clockdiv/MechanicalTheatre/README.md

# MechanicalTheatre
Control multiple Stepper Motors with Blender Timeline
