clockdiv/MechanicalTheatre/HARDWARE/Bedienung Platine.pdf

# Power Consumption

5V, 500mA
24V, ??mA

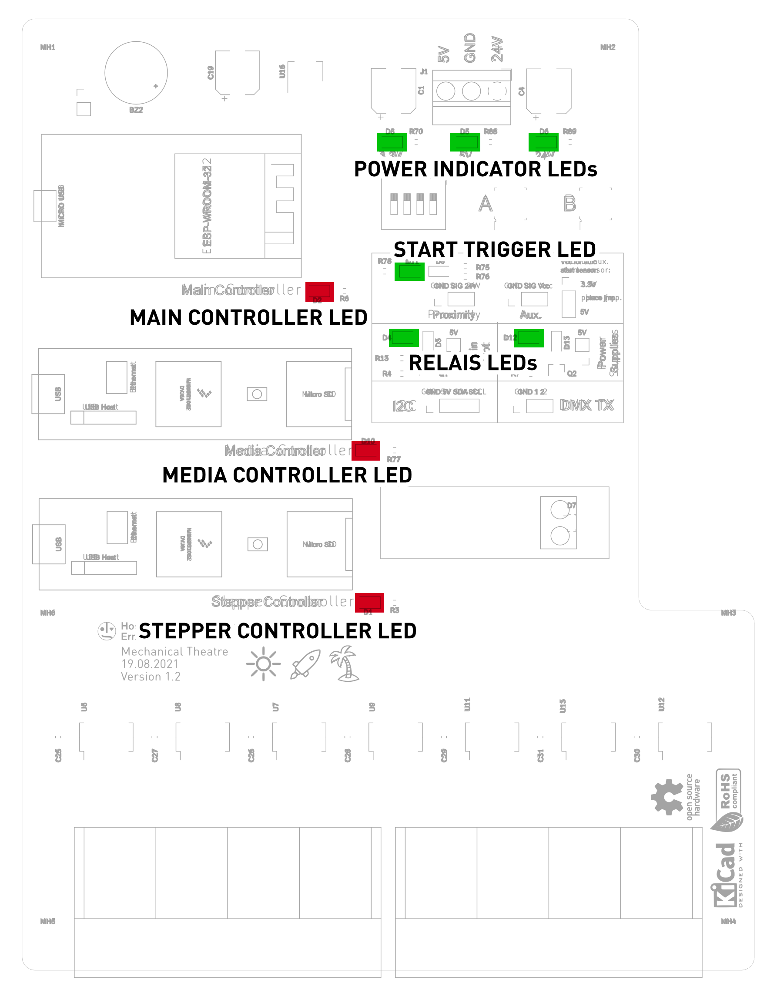
[picture p1: figure]

# LEDs

## Green LEDs Indicators

## Red LED “Main Controller” Status and Error Messages

## Red LED “Media Controller” Status and Error Messages

## Red LED “Stepper Controller” Status and Error Messages

Power Indicator LEDs | Check if Board is powered with all necessary voltages
Start Trigger LED | Lights up when the Coin-Sensor (or an auxillary sensor) is triggered
Relais LED | Corresponding LED lights up when either the Power Supply Relais or the solenoid at the coin slot is triggered
of | everything ok, waiting for start (__IDLE)
blinks fast (100ms) | ESP32 waits for teensy to reset (__WAIT_FOR_TEENSY)
blinks slow (1s) | Show is Playing (__PLAY)
blinks very slow (2s) | Stepper Controller is in test-mode (__HARDWARE_TEST)
of | everything ok, waiting for start (__IDLE)
blinks slow (1s) | Show is Playing (__PLAY)

blink codes with two seconds pause between blink-code:

1 blink | Initialization of SD-Card failed
2 blinks | Failed to read files from SD-Card
3 blinks | Failed to write files to SD-Card
of | everything ok (__IDLE)
blinks fast (100ms) | Resetting Motors (__RESET, __WAIT_FOR_MOTOR_INIT)
blinks slow (1s) | Show is Playing (__PLAY)
blinks very slow (2s) | Stepper Controller is in test-mode (__HARDWARE_TEST)

blink codes with two seconds pause between blink-code:

1 blink | Initialization of SD-Card failed
2 blinks | Failed to read files from SD-Card

# Dip Switch

# Buttons

# Buzzer (Status and Error Messages)

# RJ45 Terminals

DMX Transmitter - on Port 16 at the RJ45 terminal

- via the three-pin jumper labeled “DMX TX”
- via the green terminal on the blue MAX485 board

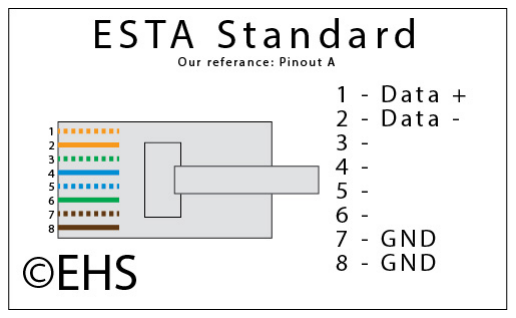
[picture p2: figure]

Port 16 at the RJ45-Terminal follows the ESTA Standard connection:
1 | Data + (A)
2 | Data - (B)
3-8 | GND
1 | auto-repeat on / of
2 | keep 24V Power Supply always on

3

4 | buzzer on / of
A | start show
B | stop show
5 | 6 | 7 | 8 | 13 | 14 | 15 | 16
1 | 2 | 3 | 4 | 9 | 10 | 11 | 12

# Test Mode

Don’t use the TestMode when all motors are attached at the installation. Motors will run without stopping at the end-switches!

1) Hold down button A while powering on OR hold down button A and press RST on Main Controller.
Only the MainController is now in TestMode:
- Three red LEDS (MainController, Relais Coinslot, Relais Power) toggle every two seconds and a short “be-beep” sounds from the speaker.
- When a serial monitor connection is established with the ESP32, the states of the buttons are presented there
2) When in TestMode, press:
- Button A to start Media Codntroller (plays the show)
- Button B to start Stepper Controller in TestMode (all motors drive slowly and stop when the endswitch is pressed)
