clockdiv/MechanicalTheatre/HARDWARE/Beschriftung RJ45-Buchsen.pdf

5 Pferde 1 | 6 Pferde 2 | 7 Reiter 1 | 8 Reiter 2
1 Ufo X-Achse | 2 Ufo Y-Achse | 3 Schwäne schwim. | 4 Schwäne tauchen
13 Stop Schild | 14 N.C. | 15 N.C. | 16 DMX Lichter
9 Luft-pumpe | 10 Halb-kugel | 11 Vorhang | 12 Magd
