clockdiv/MechanicalTheatre/2025-11-15-notes-part-04.pdf

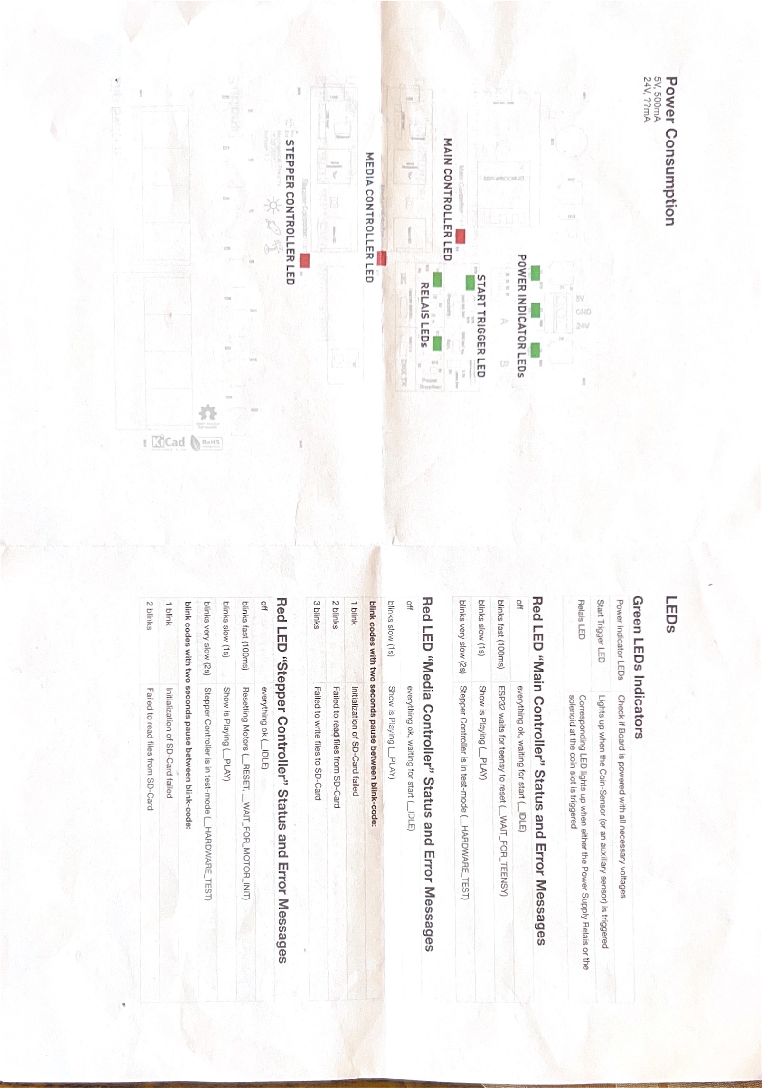
[picture p3: page 1]
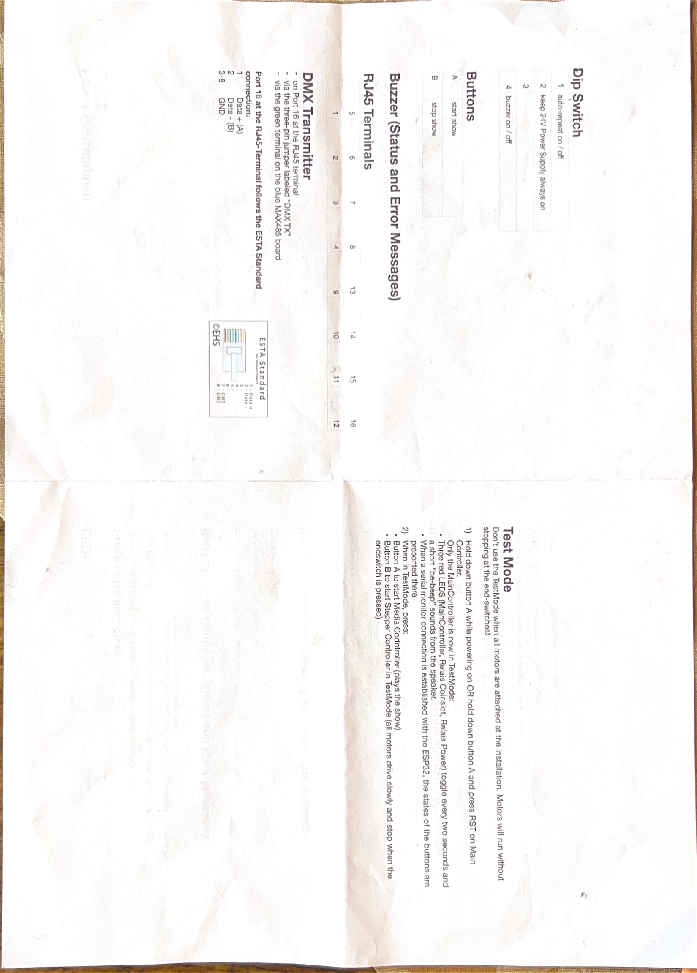
[picture p4: page 2]
