clockdiv/MechanicalTheatre/HARDWARE/LEDWall schematic.jpg

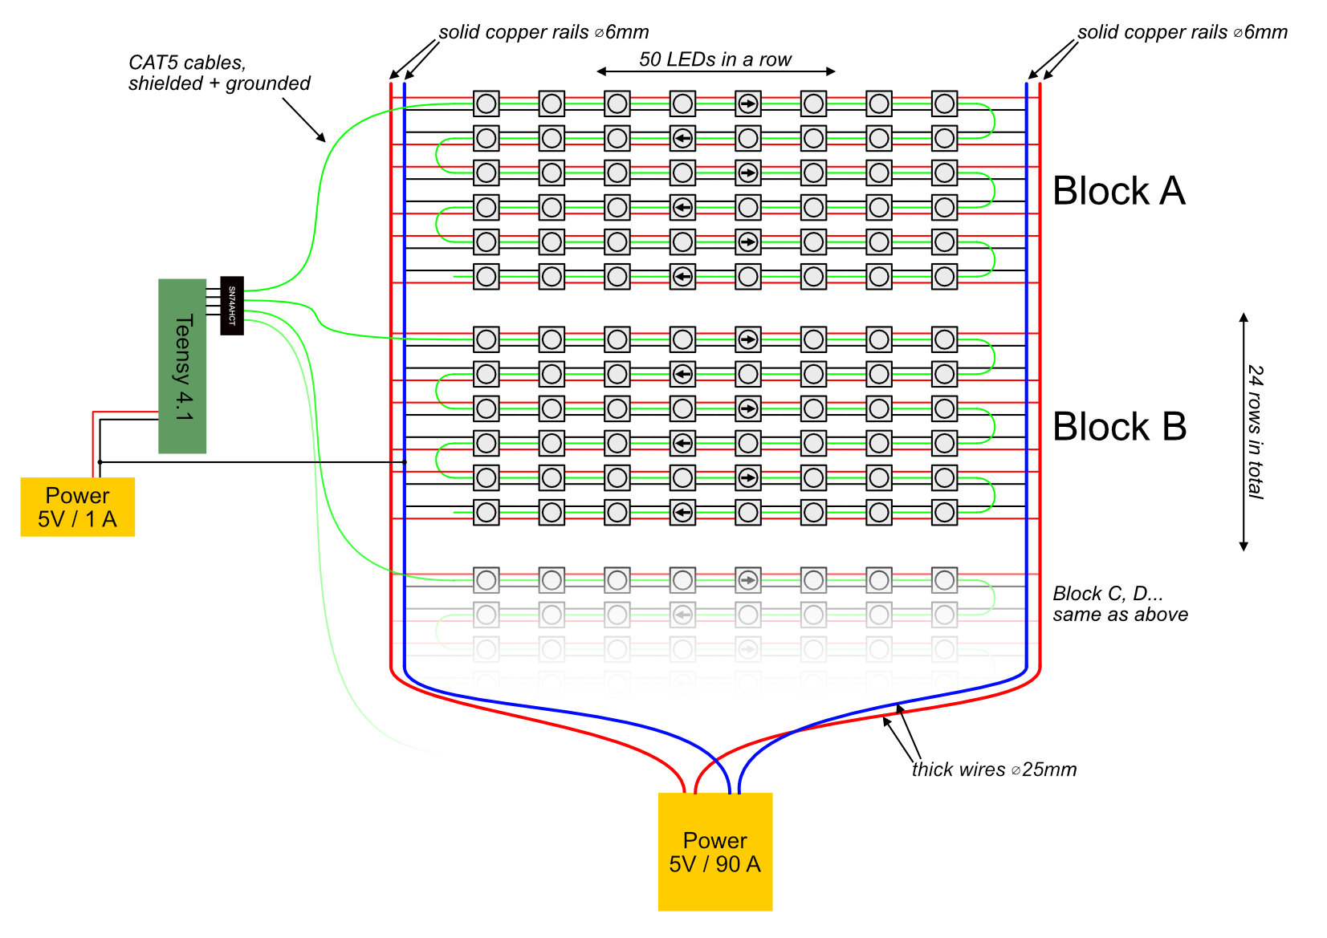
HARDWARE/LEDWall schematic.jpg
