clockdiv/MechanicalTheatre/HARDWARE/PCB/MechanicalTheatre/Silkscreen.png

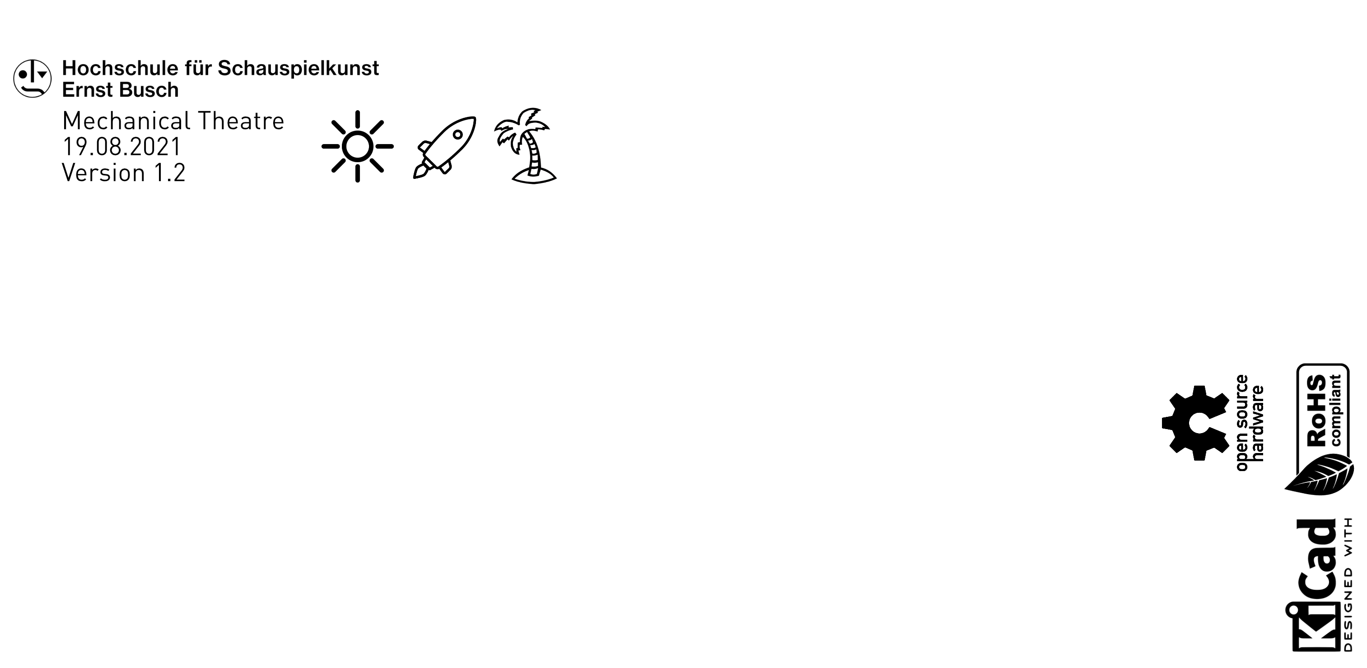
HARDWARE/PCB/MechanicalTheatre/Silkscreen.png
