clockdiv/MechanicalTheatre/HARDWARE/RJ45-Terminalblock-Adapter-KiCad-screenshot.png

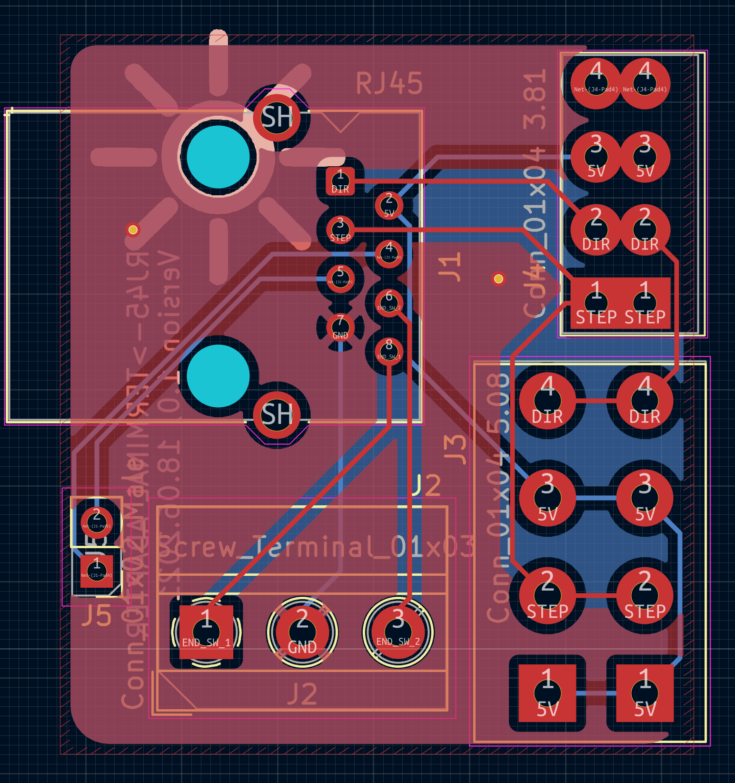
HARDWARE/RJ45-Terminalblock-Adapter-KiCad-screenshot.png
