clockdiv/MechanicalTheatre/HARDWARE/bom.xls

siehe Digikey Warenkorb | SMD LED grün | 1206
https://www.digikey.de/product-detail/de/würth-elektronik/150060SS75000/732-4979-1-ND/4489902 | SMD LED rot | 1206
https://www.digikey.de/product-detail/de/switchcraft-inc/PQG3FST112/SC1548-ND/1289547 | XLR-Connector Buchse / Flanschdose Senkrecht
https://www.digikey.de/product-detail/de/diodes-incorporated/AP2111H-3-3TRG1/AP2111H-3-3TRG1DICT-ND/4505138 | 3.3V spannungsregler
https://www.digikey.de/product-detail/de/texas-instruments/LM1117IMP-3-3-NOPB/LM1117IMP-3-3-NOPBCT-ND/483058 | 3.3V spannungsregler
https://www.digikey.de/product-detail/en/semtech-corporation/SM712.TCT/SM712CT-ND/1000976 | TVS Diode Transient Voltage Suppressor
https://www.digikey.de/product-detail/de/micro-commercial-co/1N4148W-TP/1N4148WTPMSCT-ND/717311 | Diode | SOD-123
https://www.digikey.de/product-detail/de/united-chemi-con/EMHL350ARA221MHA0G/565-EMHL350ARA221MHA0GCT-ND/10487113 | Elko 220uF / 35V
https://www.digikey.de/product-detail/de/panasonic-electronic-components/EEE-1EA101P/PCE3896CT-ND/766272 | Elko 100uF / 25V
