clockdiv/MechanicalTheatre/(list of files, cad)

Other CAD files:
DEV BLENDER/DumpTimelineToFile.blend
DEV BLENDER/DumpTimelineToFile2.blend
DEV BLENDER/DumpTimelineToFile3.blend
DEV BLENDER/Ingo V2.blend
DEV BLENDER/Ingo V3.blend
DEV BLENDER/Ingo V4.blend
DEV BLENDER/Ingo V5.blend
DEV BLENDER/Timeline2DMX.blend
