clockdiv/MechanicalTheatre/HARDWARE/Schaltplan.pdf

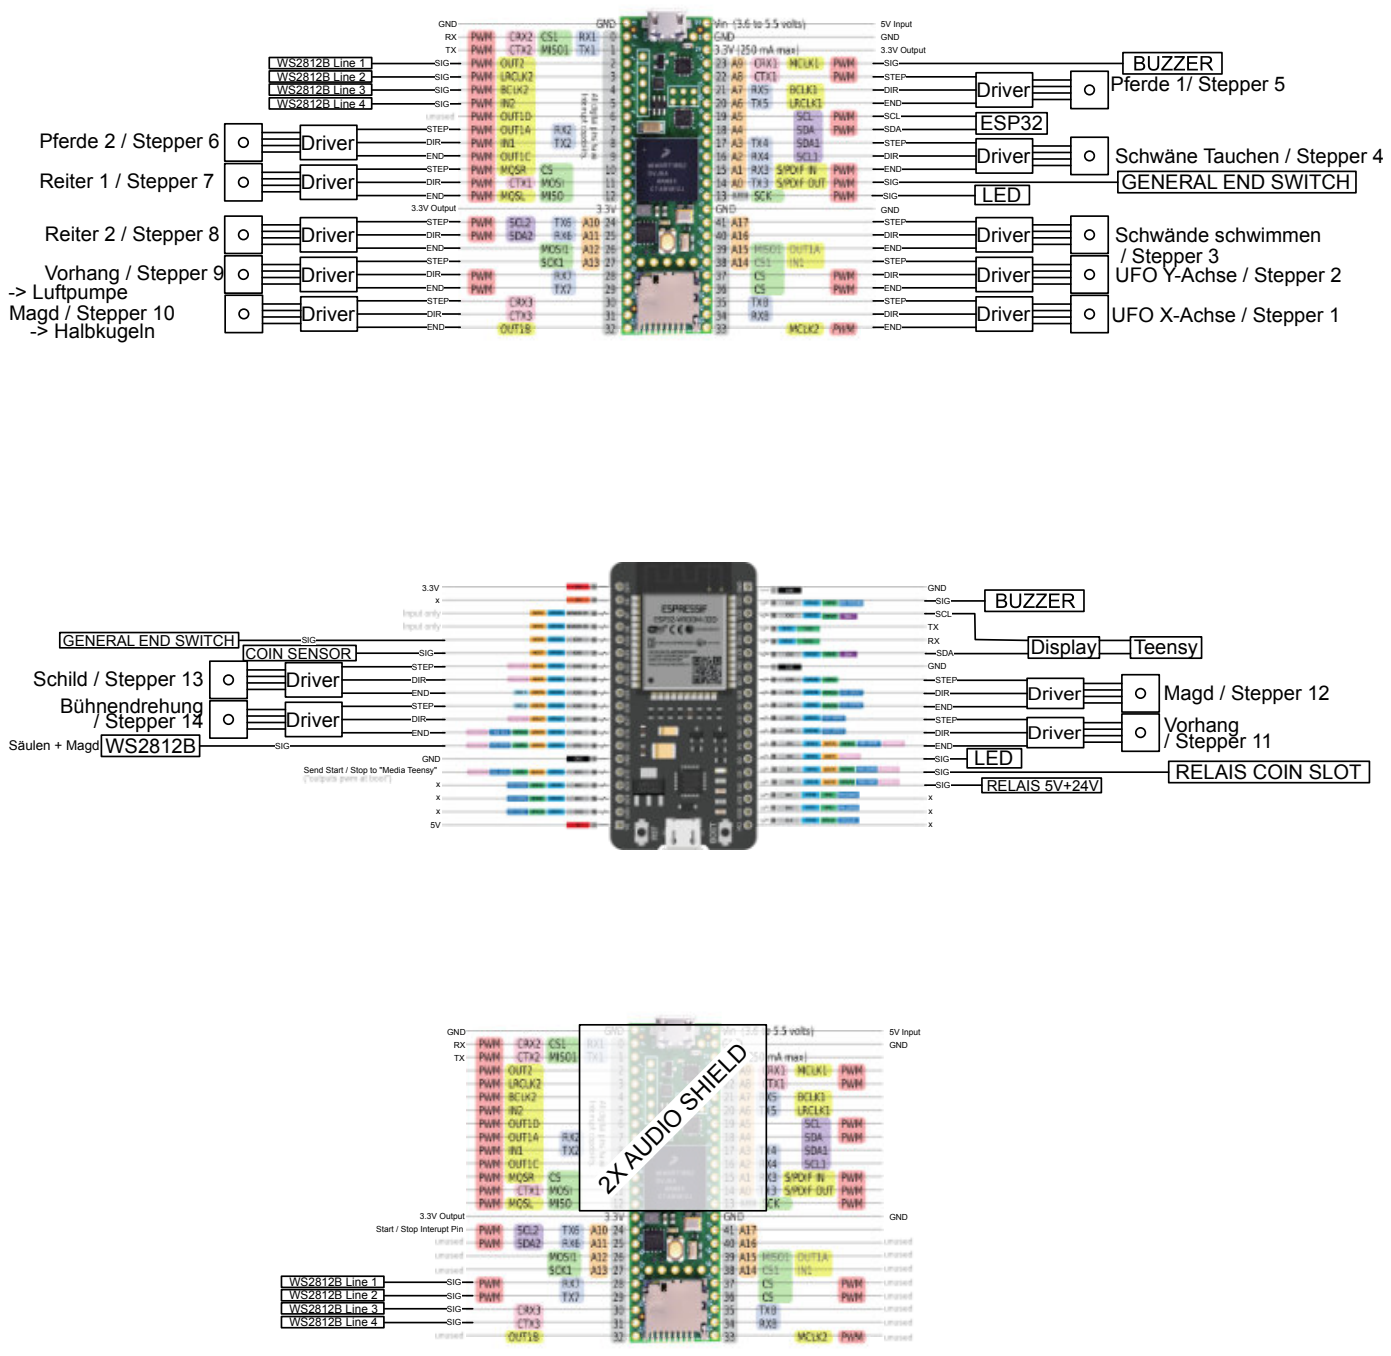
[picture p13: page 1]
ESP32 SCL; SDA; SIG; LED; GENERAL END SWITCH; Säulen + Magd; COIN SENSOR; WS2812B Line 1; WS2812B Line 2; WS2812B Line 3; WS2812B Line 4; RELAIS COIN SLOT SIG; RELAIS 5V+24V; Display; Teensy; SCL; Driver; STEP; DIR; END; Pferde 1/ Stepper 5; UFO X-Achse / Stepper 1; Magd / Stepper 12; Vorhang; / Stepper 11; Pferde 2 / Stepper 6; Schild / Stepper 13; Reiter 1 / Stepper 7; Driver Bühnendrehung / Stepper 14; Reiter 2 / Stepper 8; Vorhang / Stepper 9; -> Luftpumpe; Magd / Stepper 10; -> Halbkugeln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

Schwäne Tauchen / Stepper 4

Schwände schwimmen
/ Stepper 3
UFO Y-Achse / Stepper 2

Send Start / Stop to "Media Teensy"

Start / Stop Interupt Pin
