clockdiv/MechanicalTheatre/HARDWARE/PCB/MechanicalTheatre/MechanicalTheatre.pdf

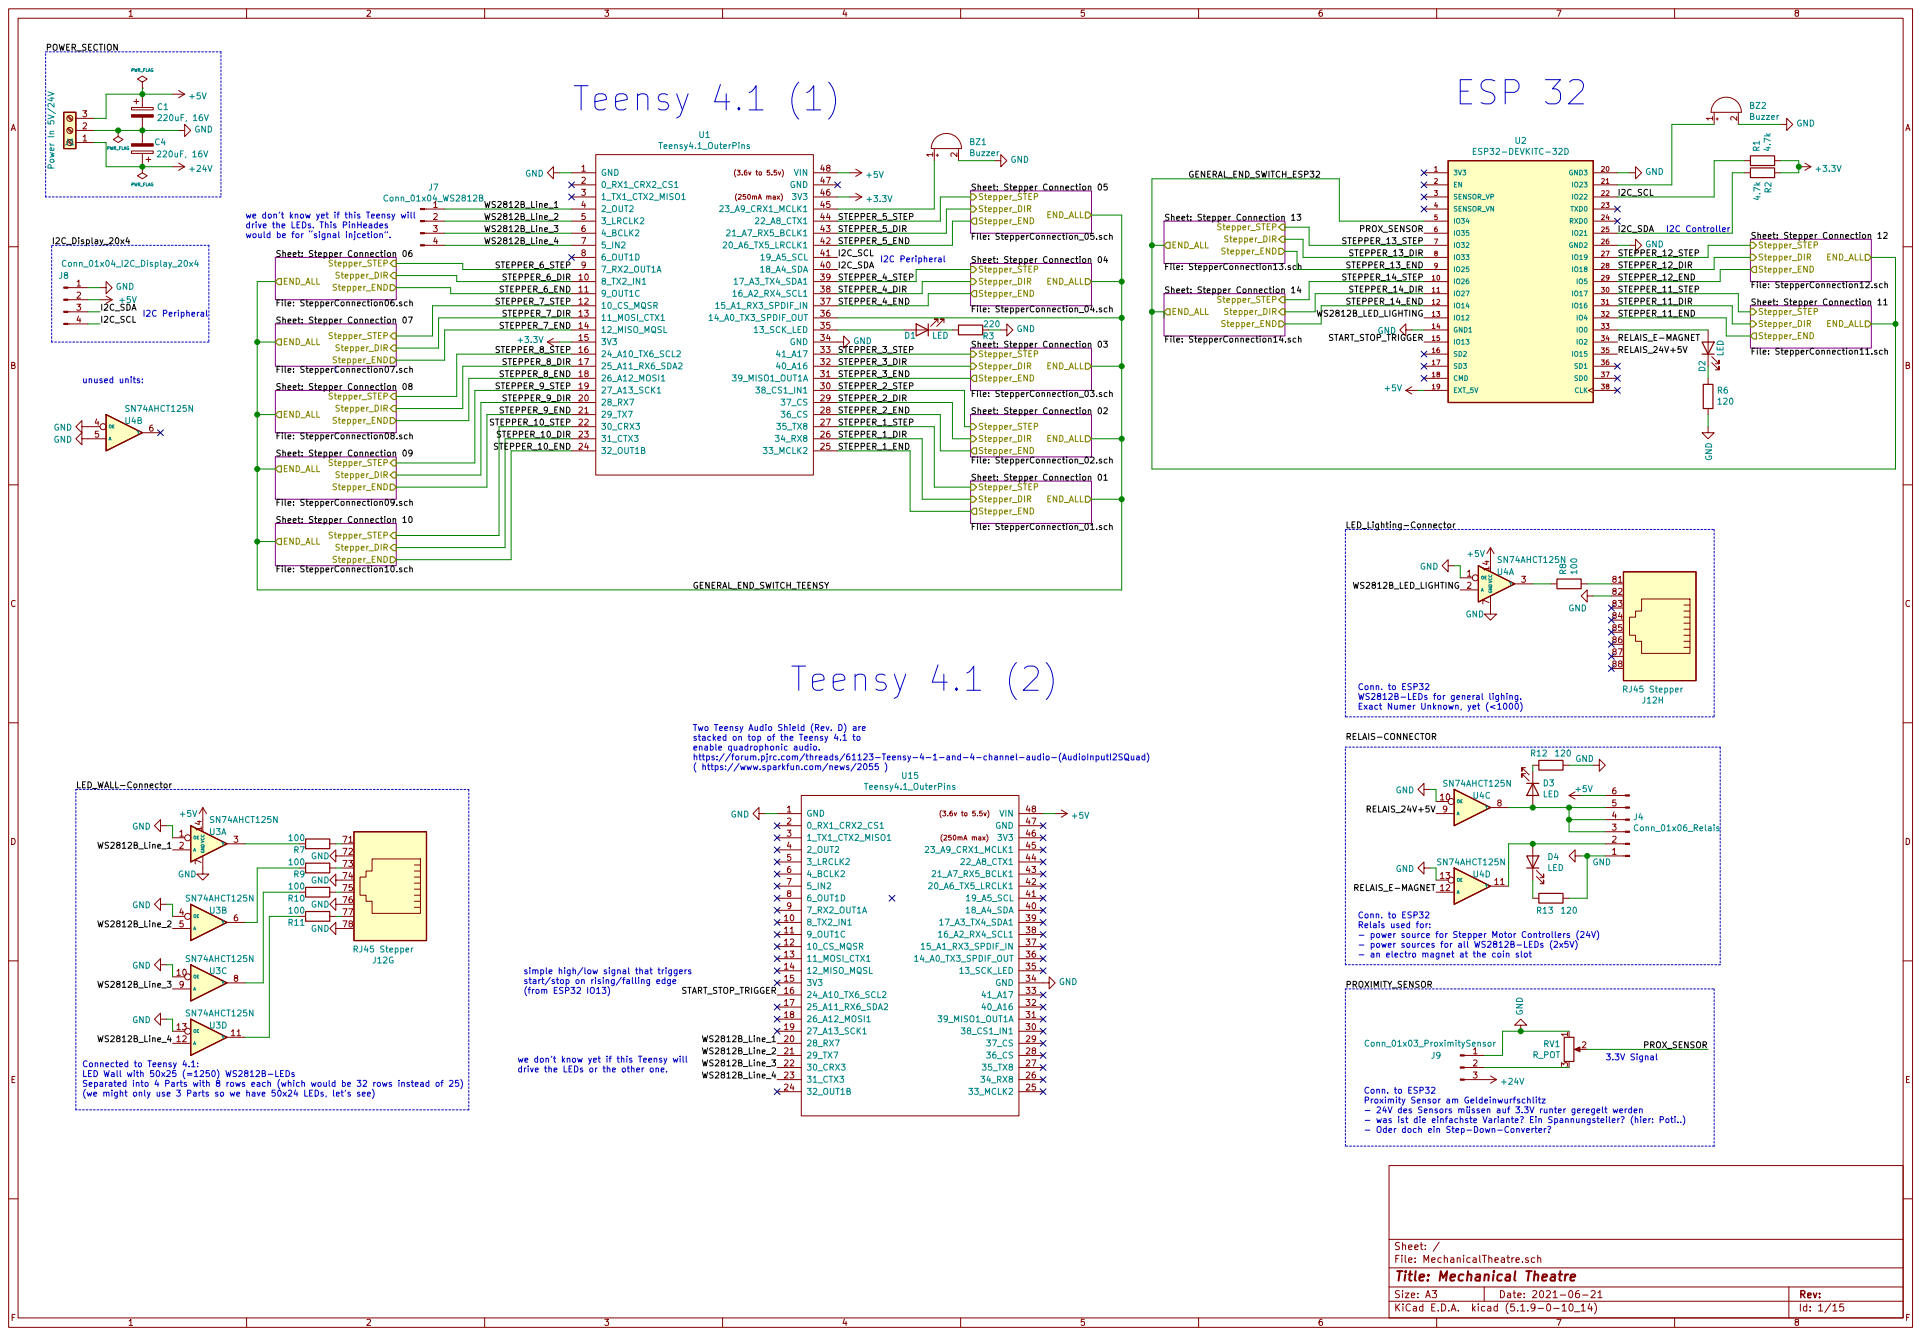
[picture p14: page 1]

we dont know yet if this Teensy will drive the LEDs. This PinHeades would be for signal injcetion.

3.3V Signal Conn. to ESP32 WS2812B-LEDs for general lighing.

Exact Numer Unknown, yet (<1000)

Two Teensy Audio Shield (Rev. D) are
stacked on top of the Teensy 4.1 to
enable quadrophonic audio.
https://forum.pjrc.com/threads/61123-Teensy-4-1-and-4-channel-audio-(AudioInputI2SQuad)

- power sources for all WS2812B-LEDs (2x5V)
- an electro magnet at the coin slot

simple high/low signal that triggers
start/stop on rising/falling edge
(from ESP32 IO13)

we dont know yet if this Teensy will drive the LEDs or the other one.

Connected to Teensy 4.1:
LED Wall with 50x25 (=1250) WS2812B-LEDs
Separated into 4 Parts with 8 rows each (which would be 32 rows instead of 25)
(we might only use 3 Parts so we have 50x24 LEDs, lets see)

Conn. to ESP32 Proximity Sensor am Geldeinwurfschlitz

- 24V des Sensors müssen auf 3.3V runter geregelt werden
- was ist die einfachste Variante? Ein Spannungsteiler? (hier: Poti..)
- Oder doch ein Step-Down-Converter?

File: MechanicalTheatre.sch Sheet: /
Id: 1/15 Title: Mechanical Theatre

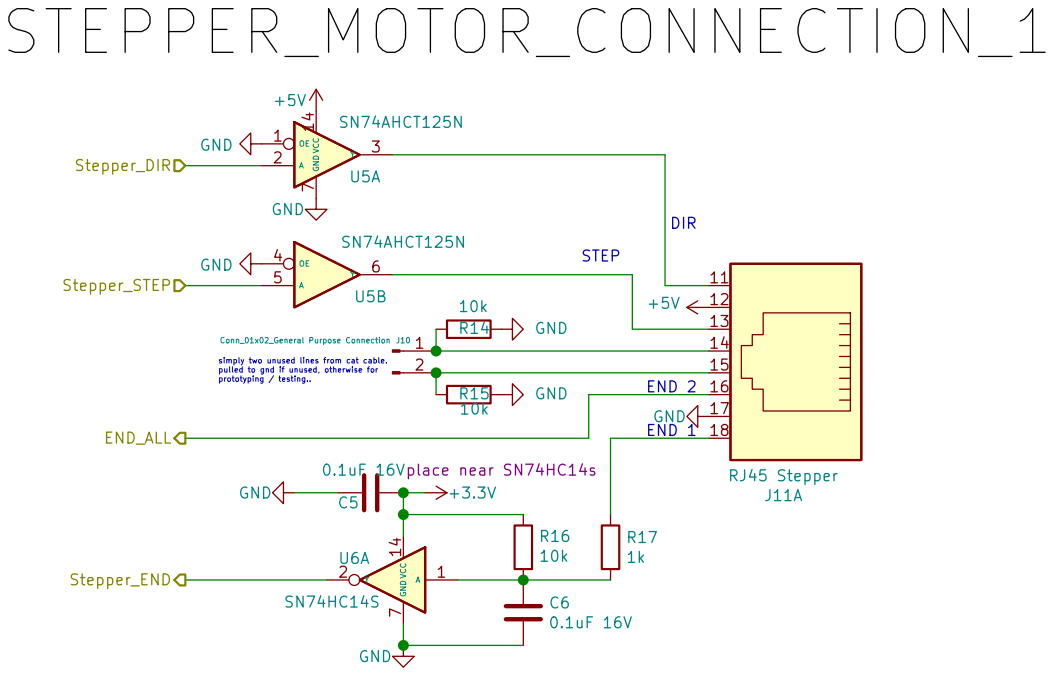
[picture p15: page 2]

Sheet: /Stepper Connection 01/
File: StepperConnection_01.sch
Id: 2/15 Title: Stepper Connection

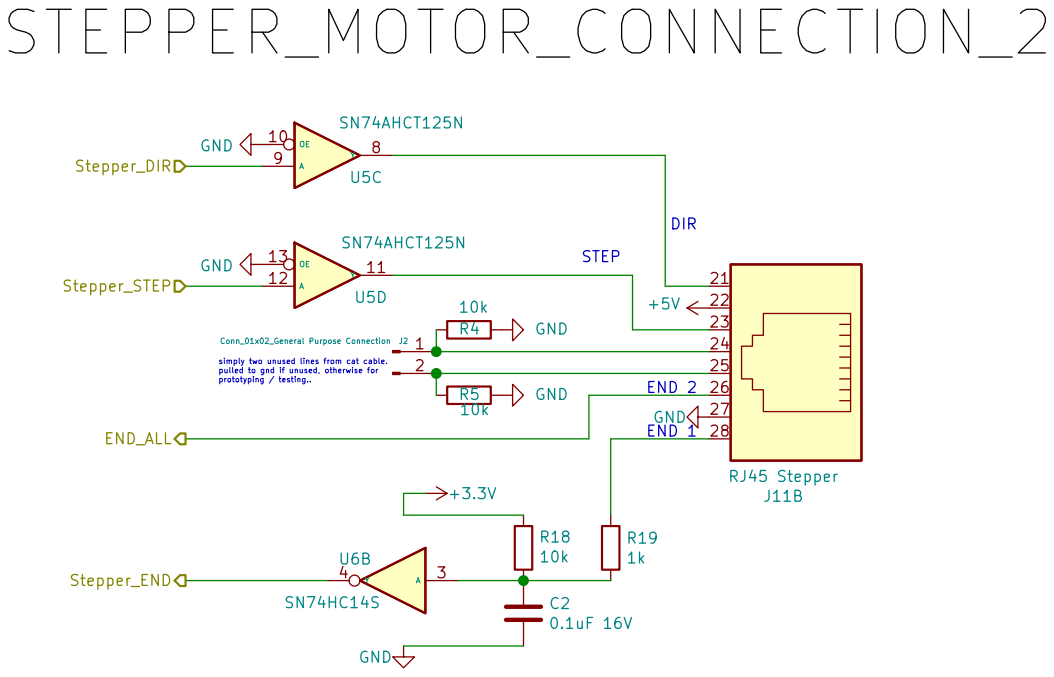
[picture p16: page 3]

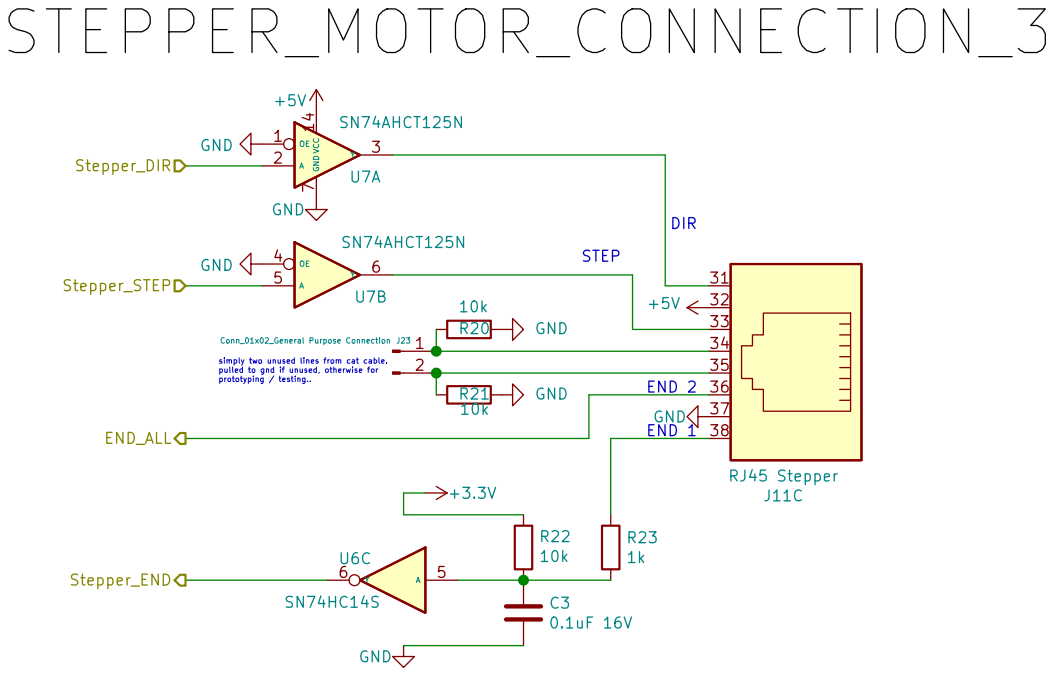
[picture p17: page 4]

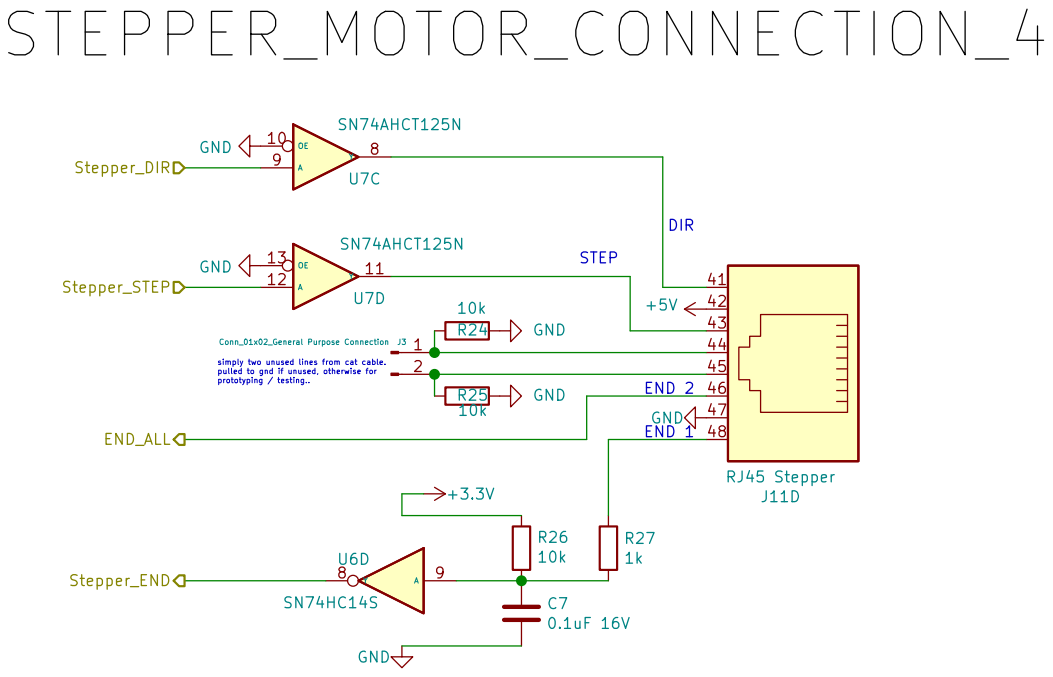
[picture p18: page 5]

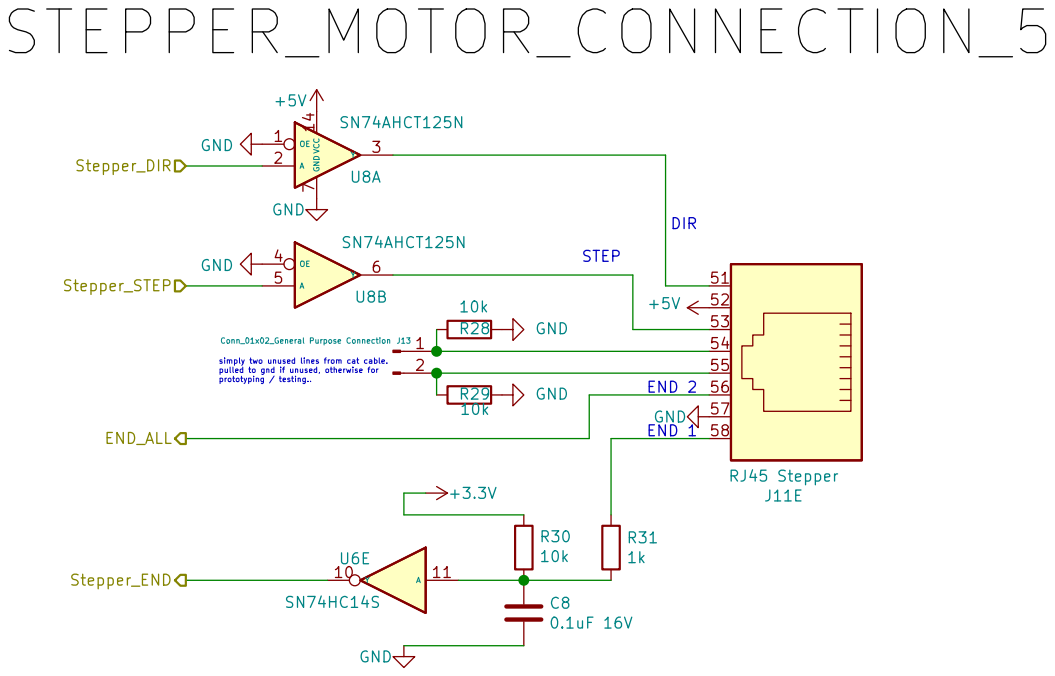
[picture p19: page 6]

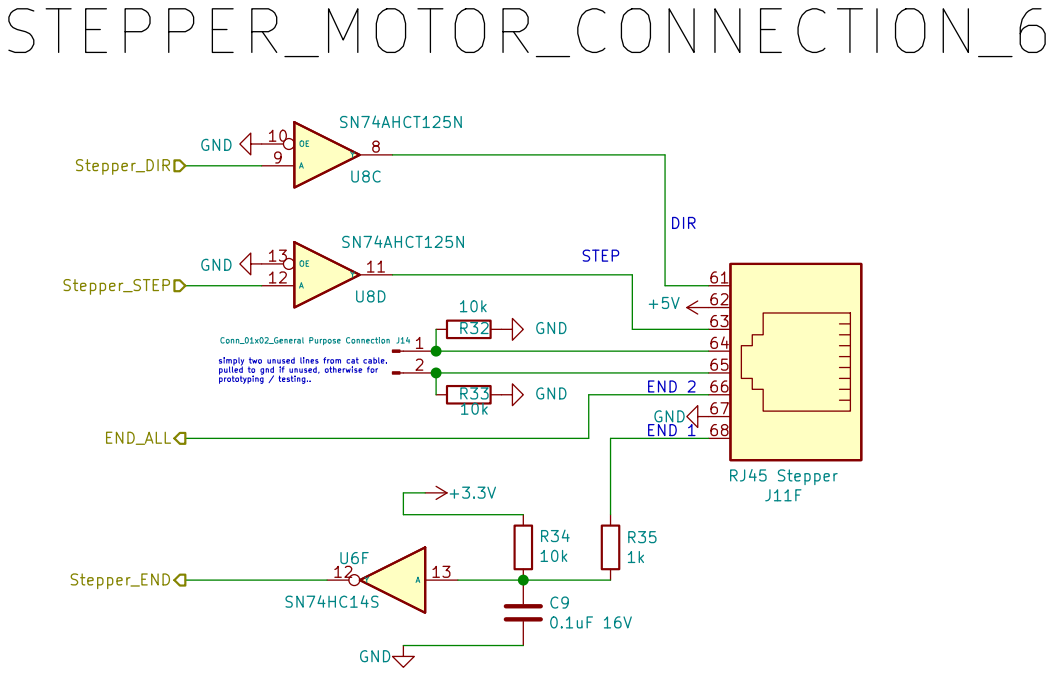
[picture p20: page 7]

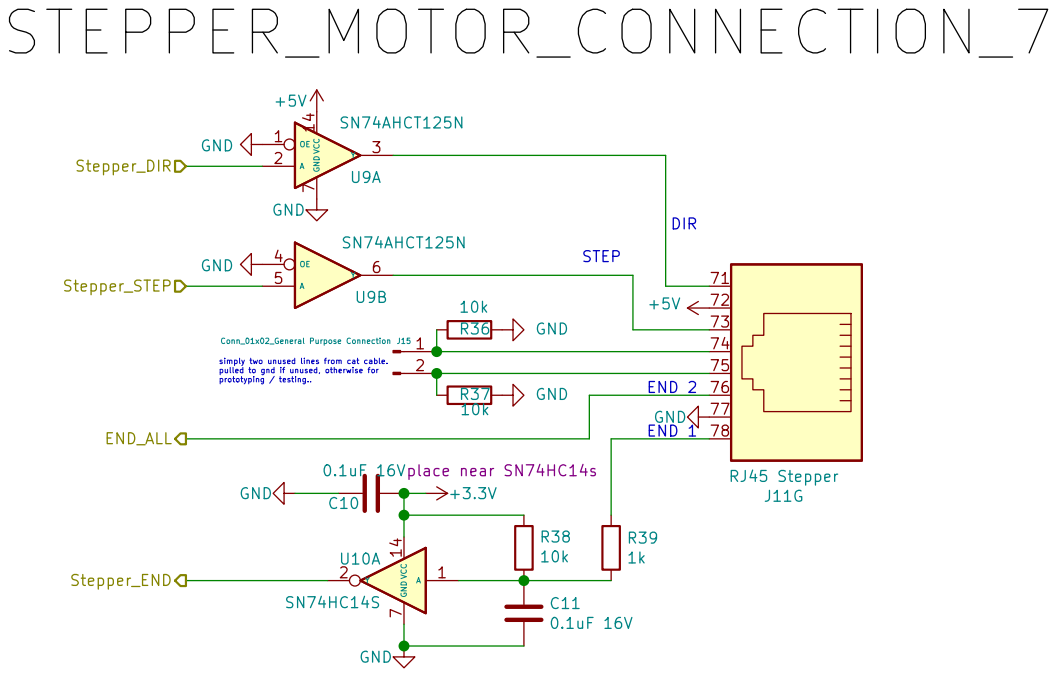
[picture p21: page 8]

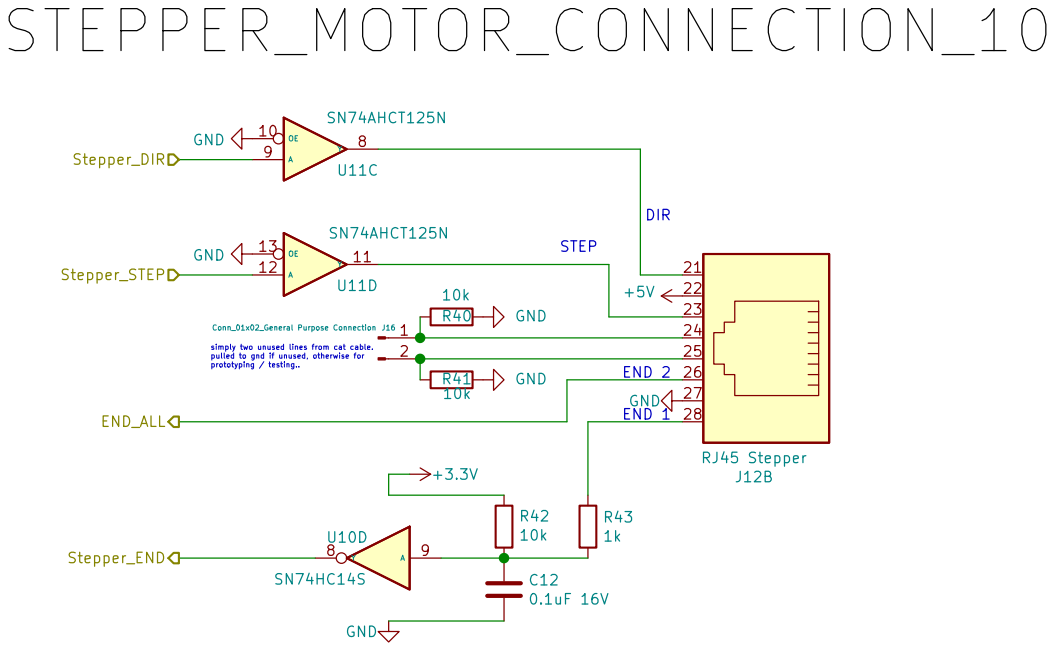
[picture p22: page 9]

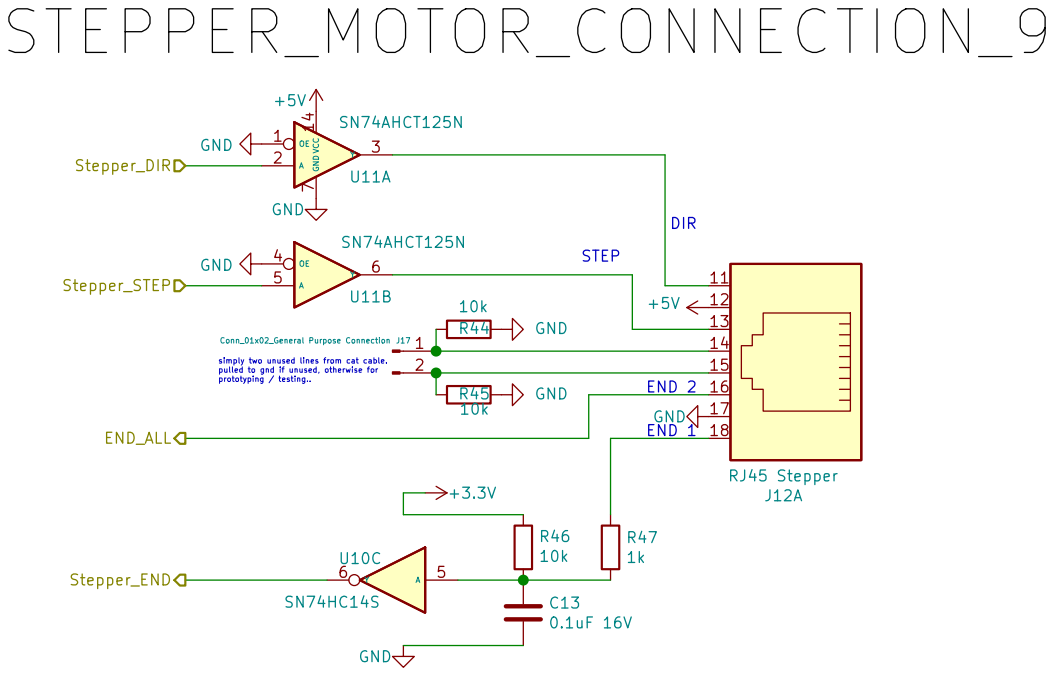
[picture p23: page 10]

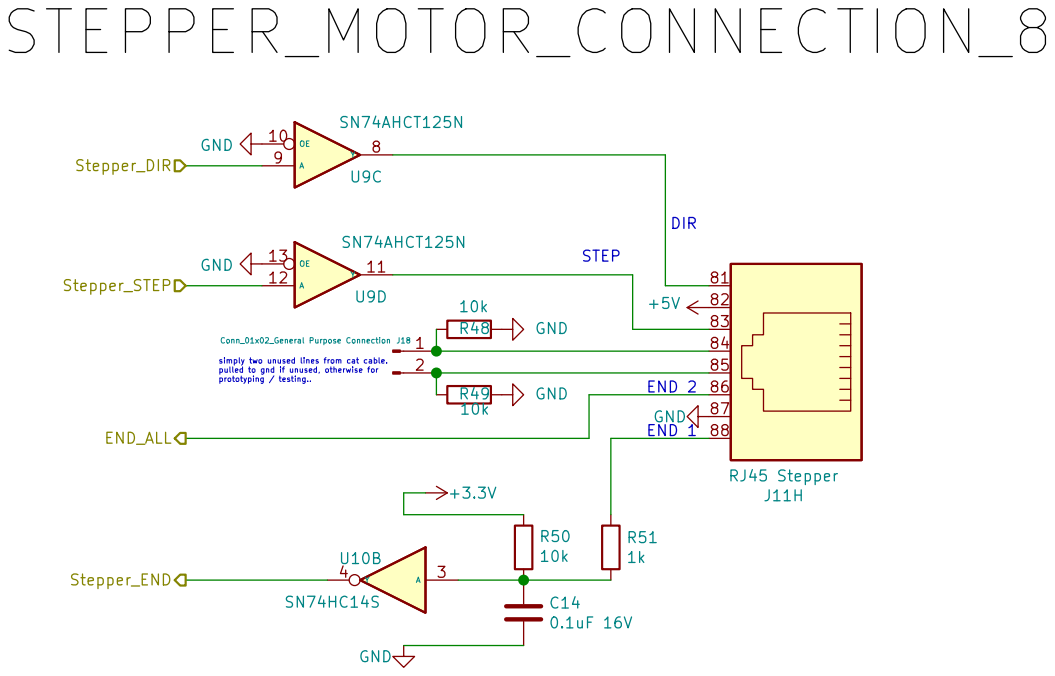
[picture p24: page 11]

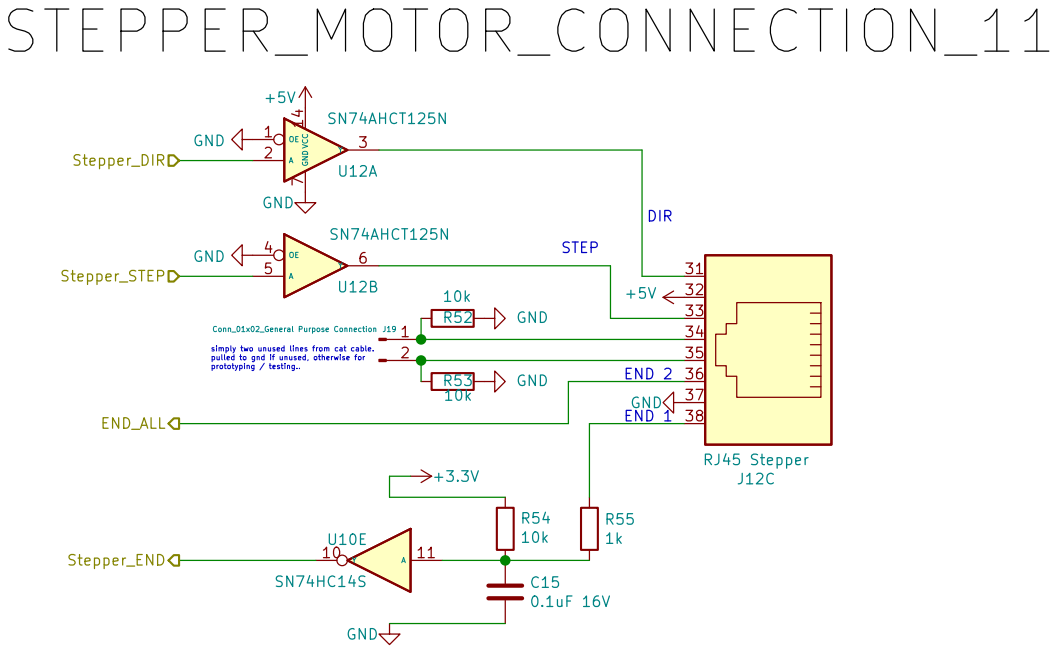
[picture p25: page 12]

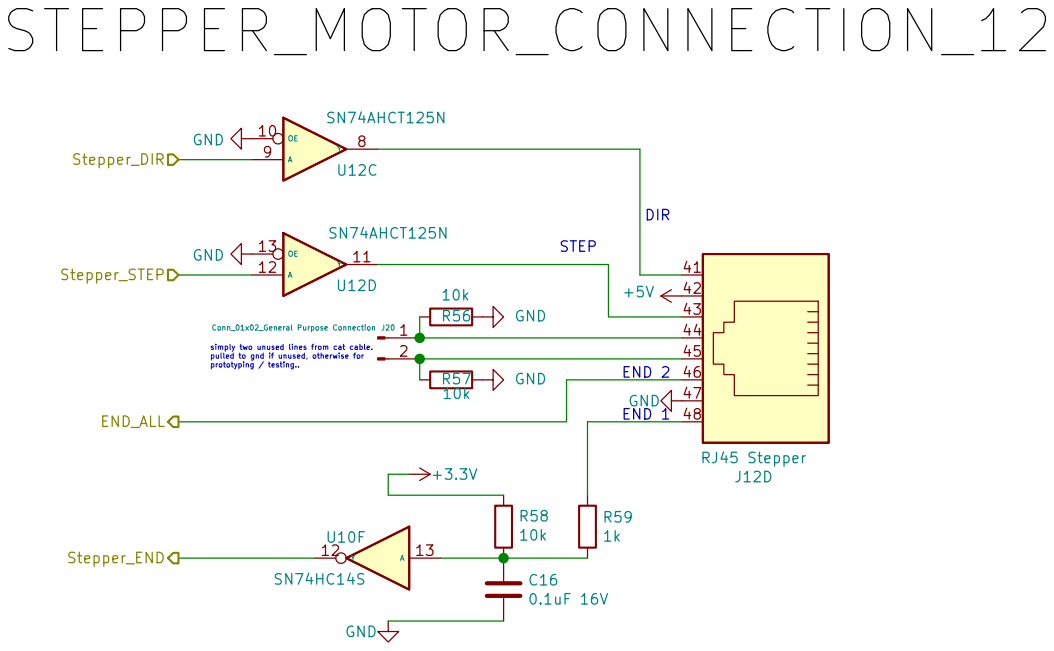
[picture p26: page 13]

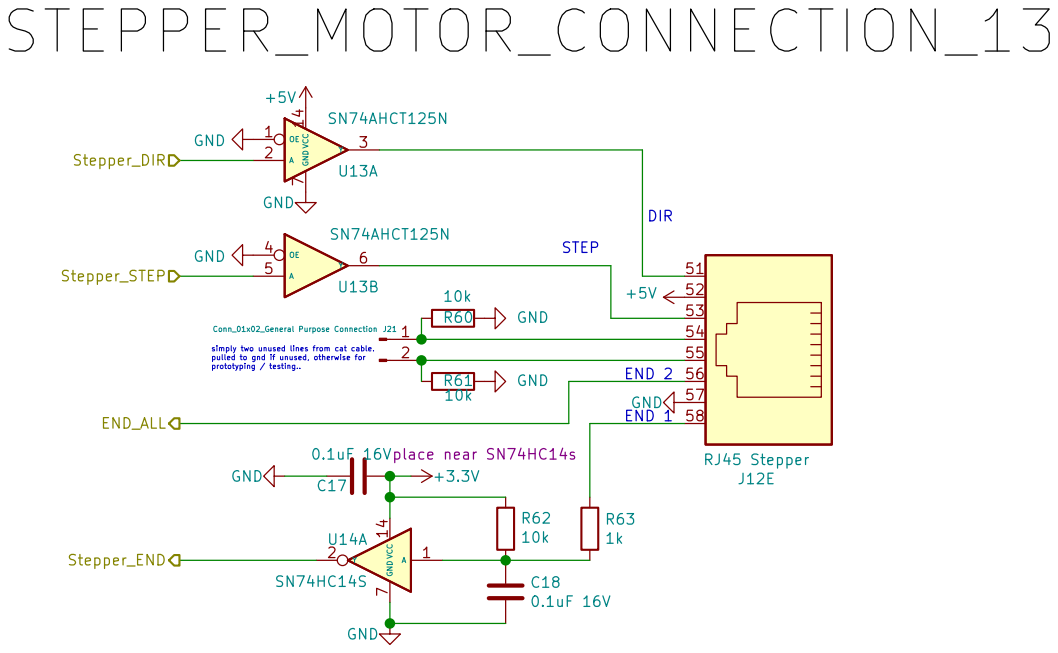
[picture p27: page 14]

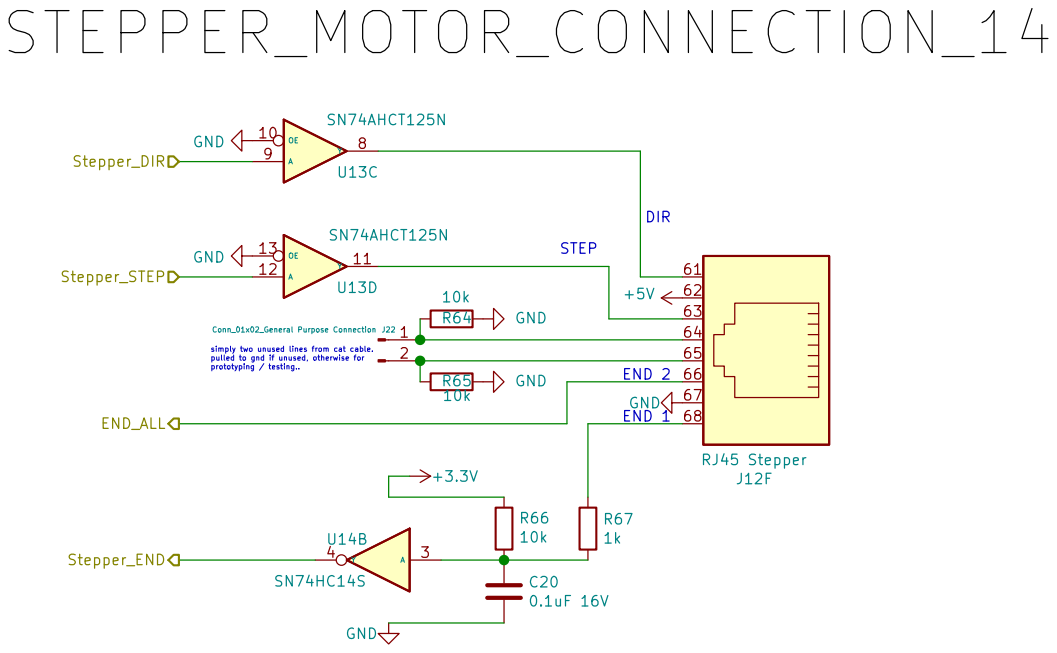
[picture p28: page 15]
