clockdiv/MechanicalTheatre/HARDWARE/RJ45-Terminalblock-Adapter-schematic.pdf

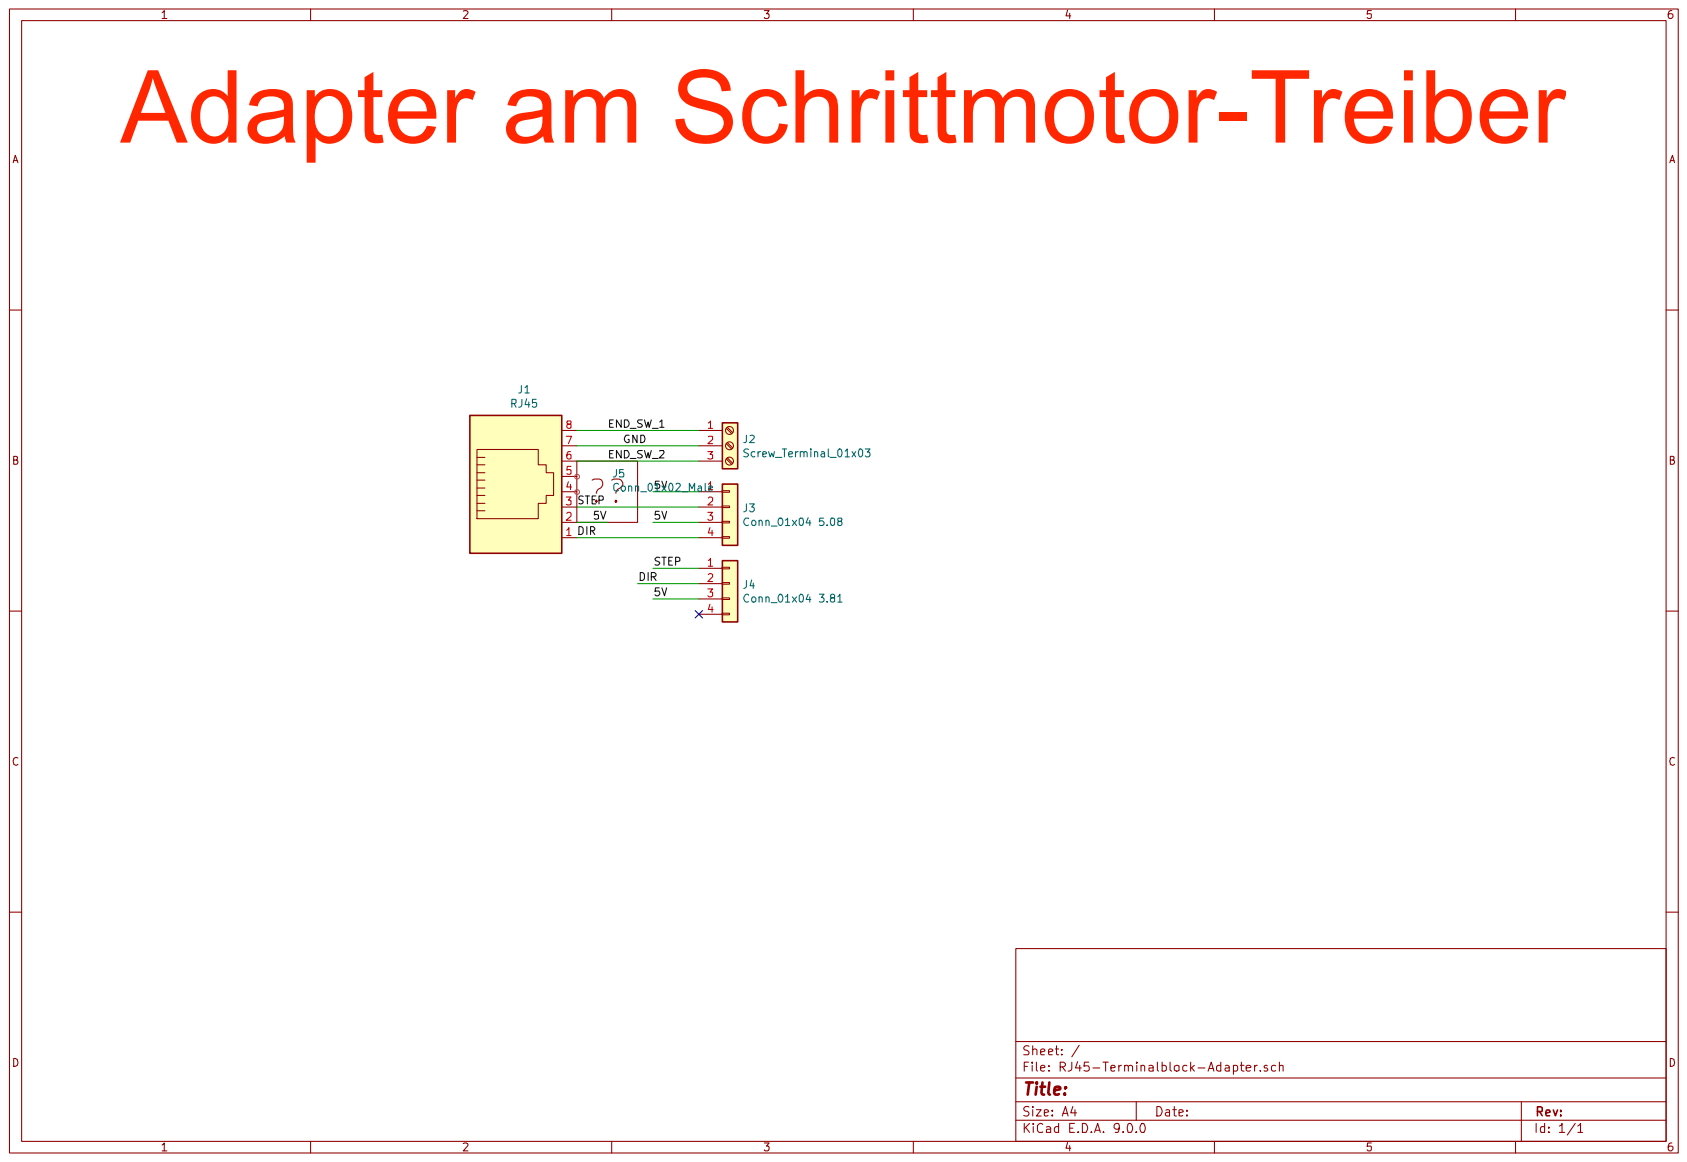
[picture p29: page 1]
