clockdiv/MechanicalTheatre/HARDWARE/PCB/RJ45-Terminalblock-Adapter/RJ45-Terminalblock-Adapter_PCB.pdf

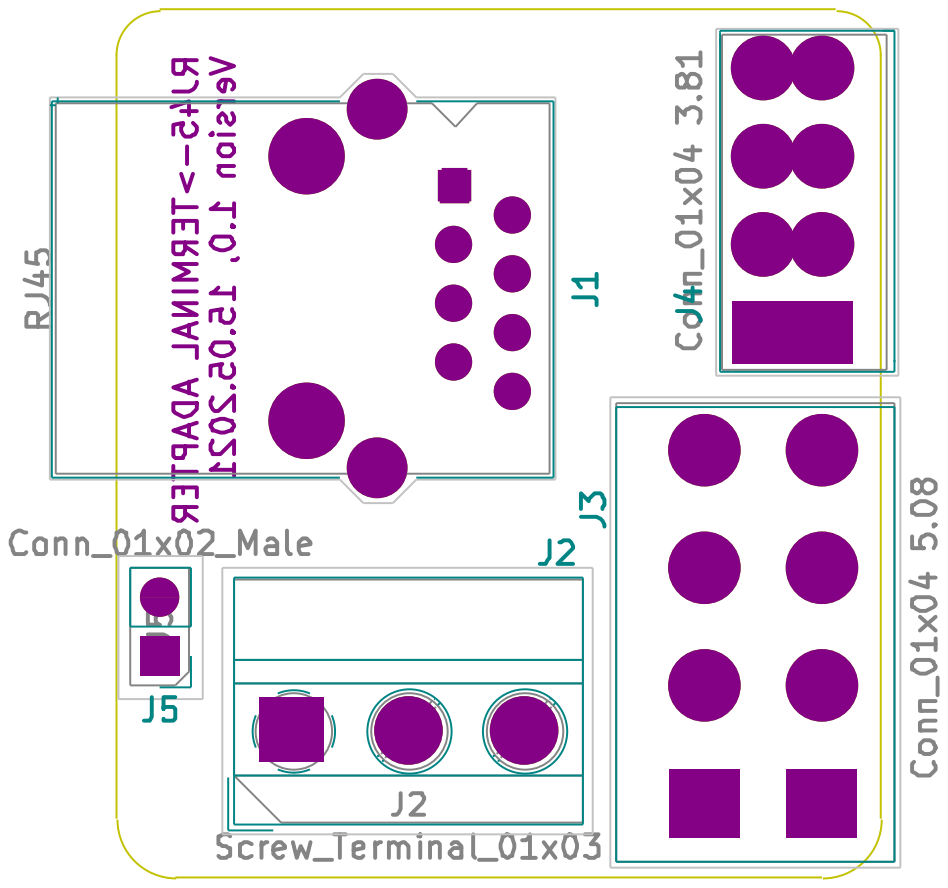
[picture p59: page 1]
