clockdiv/MechanicalTheatre/HARDWARE/PCB/MechanicalTheatre/schematics_v1.0.pdf

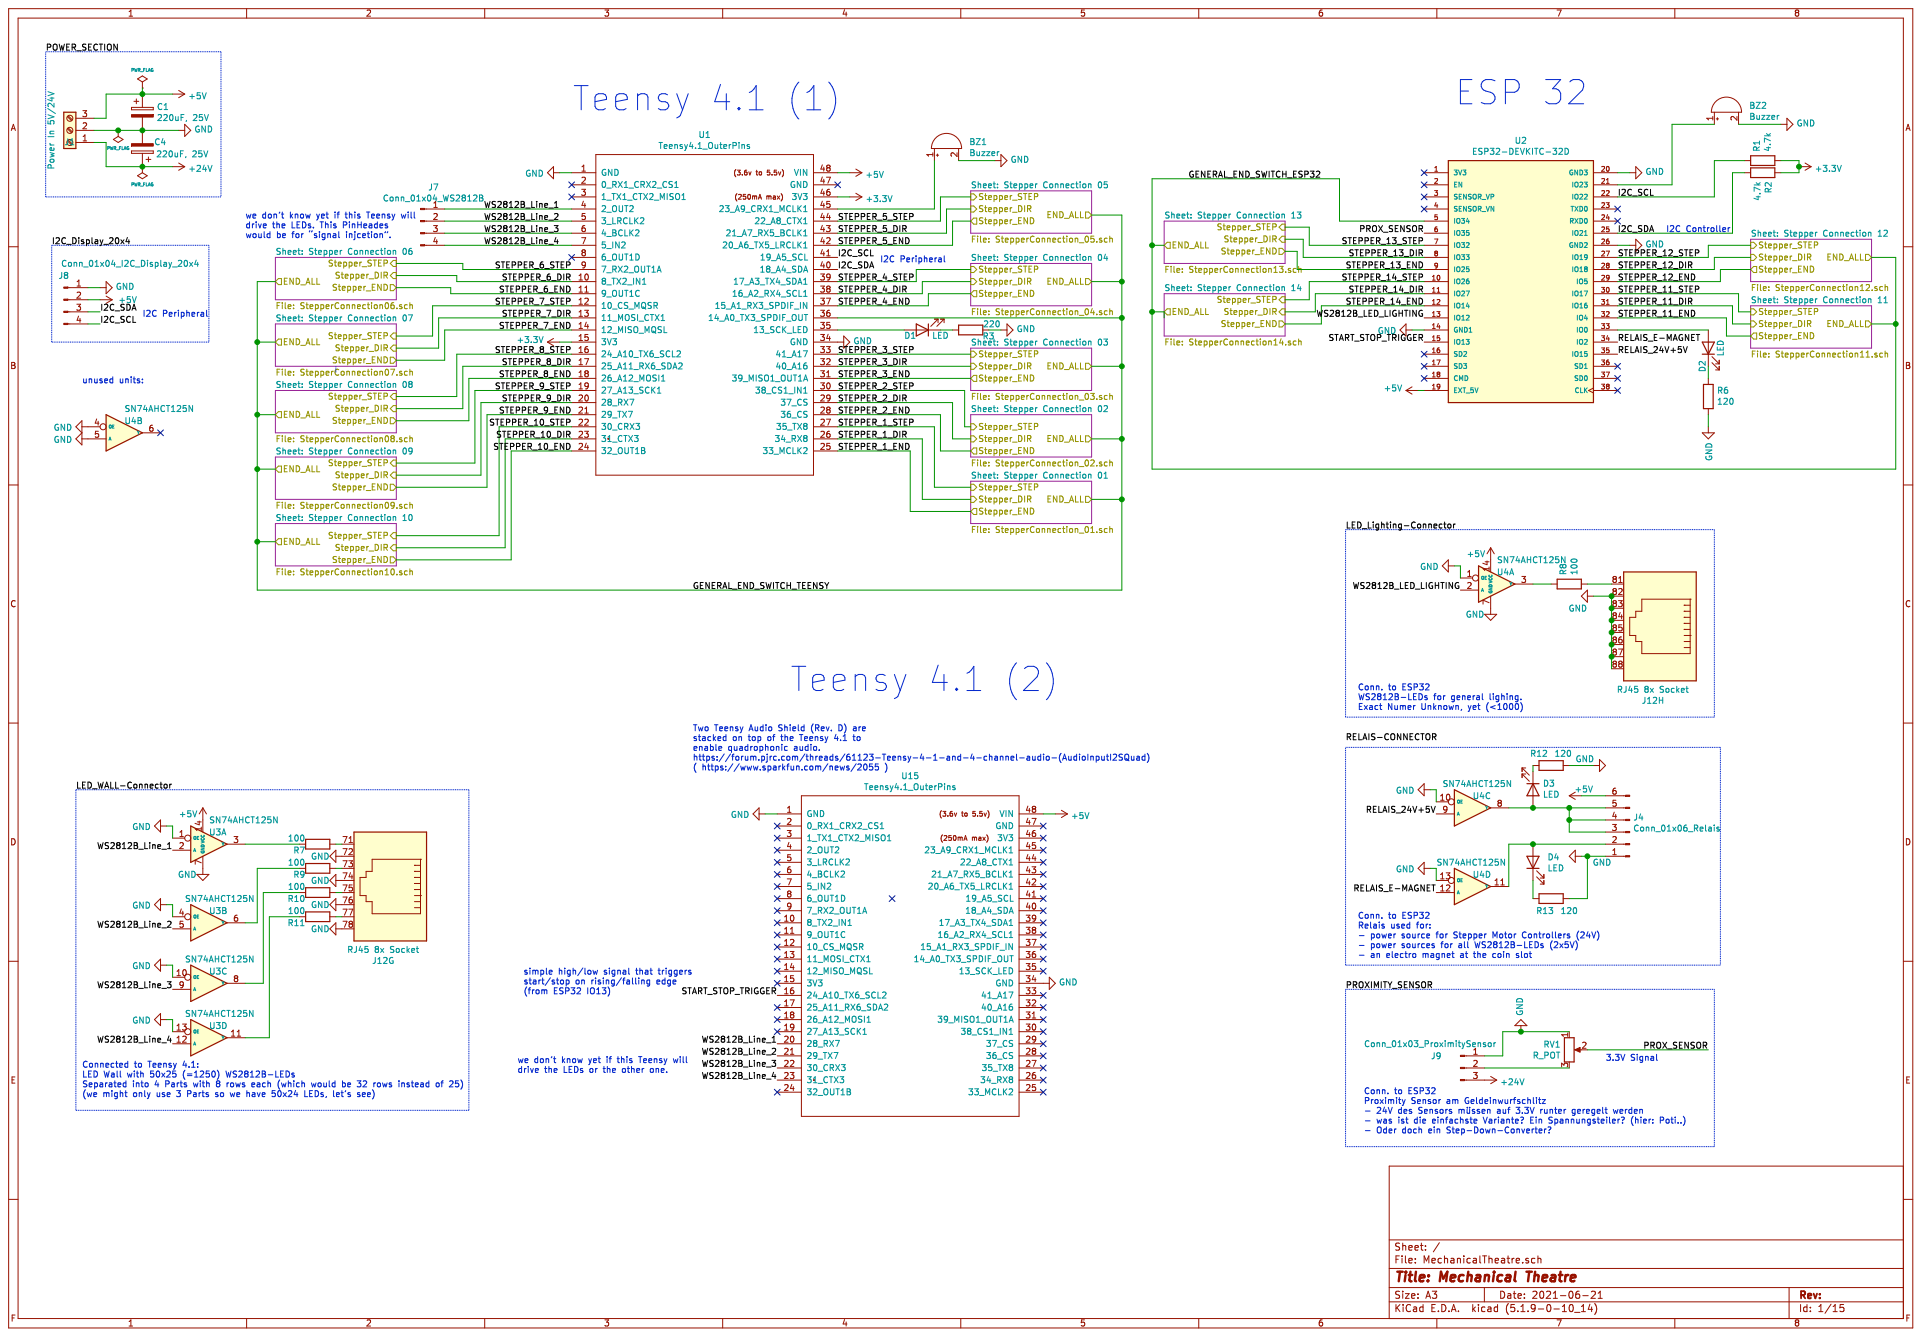
[picture p60: page 1]

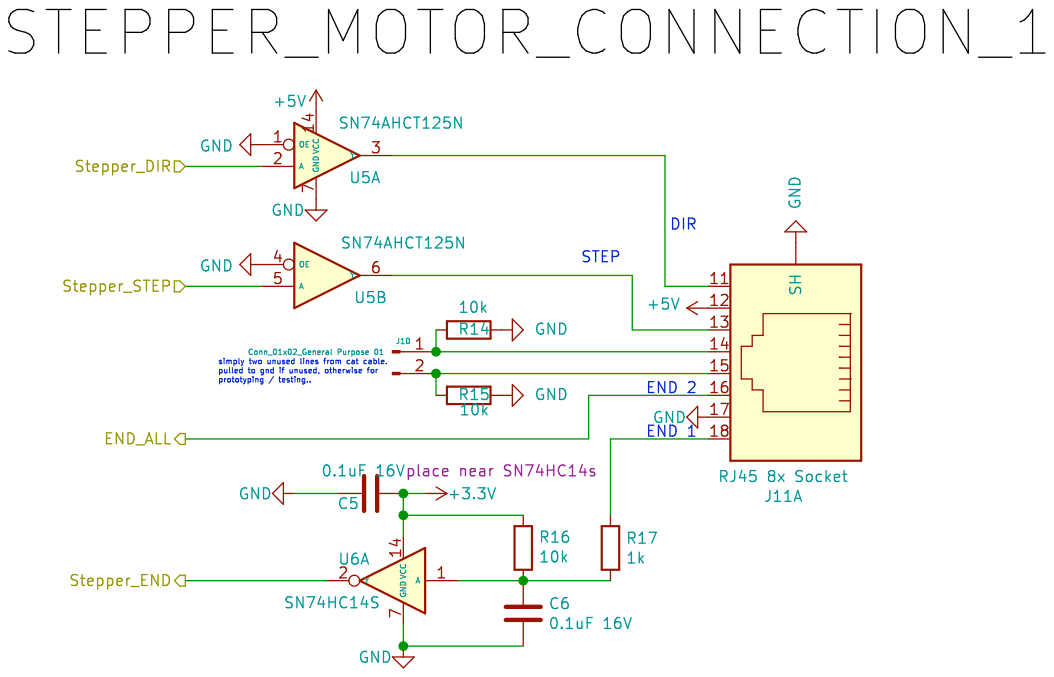
[picture p61: page 2]

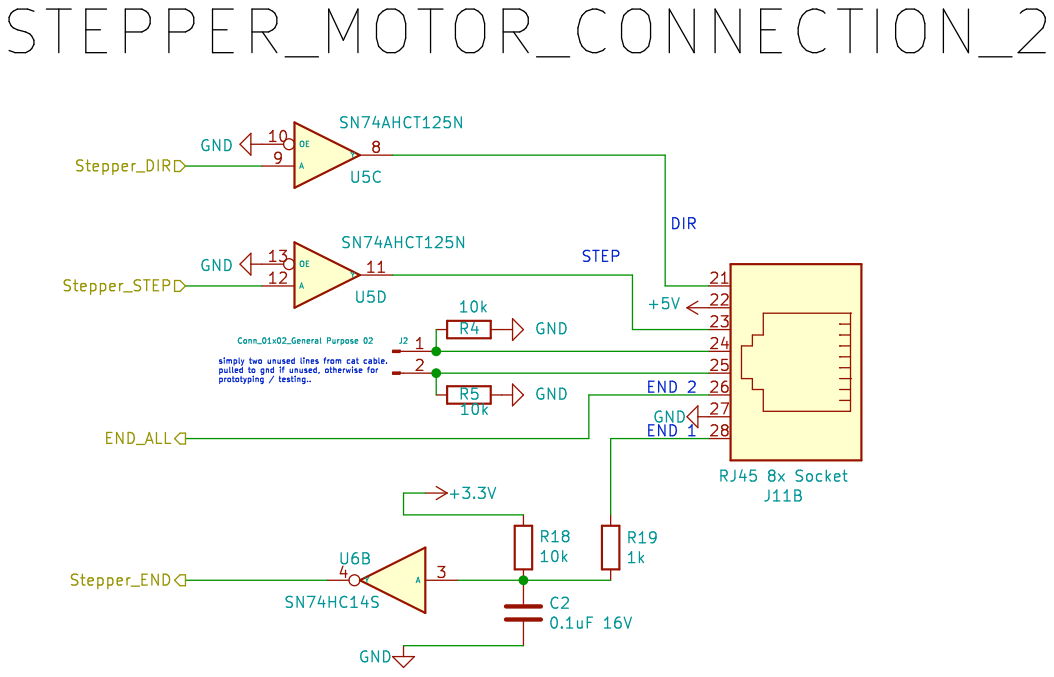
[picture p62: page 3]

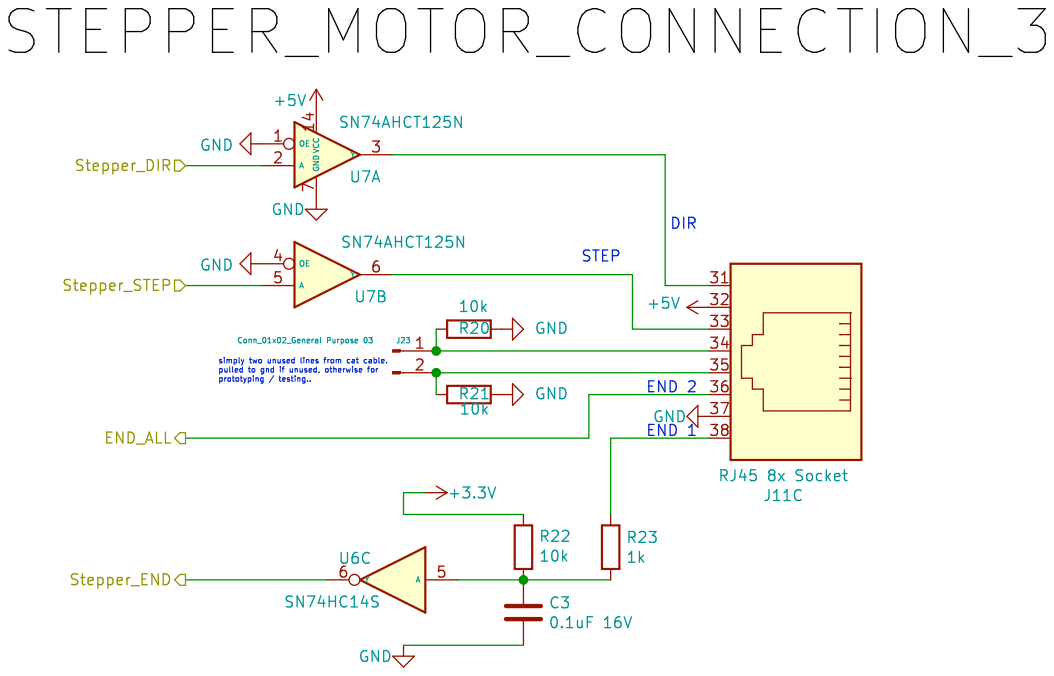
[picture p63: page 4]

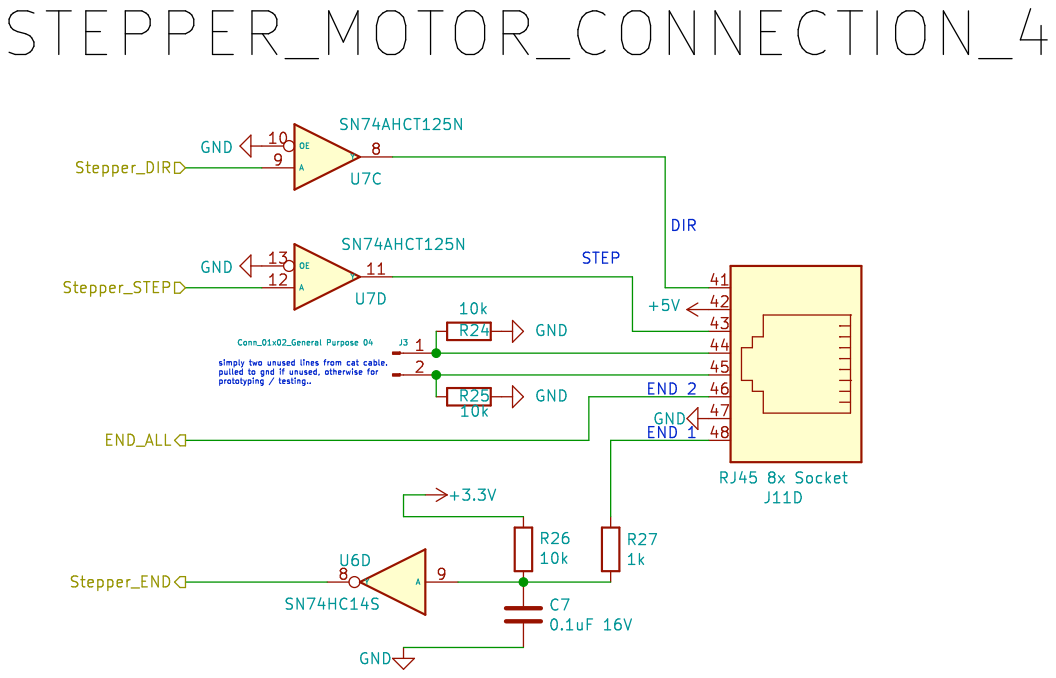
[picture p64: page 5]

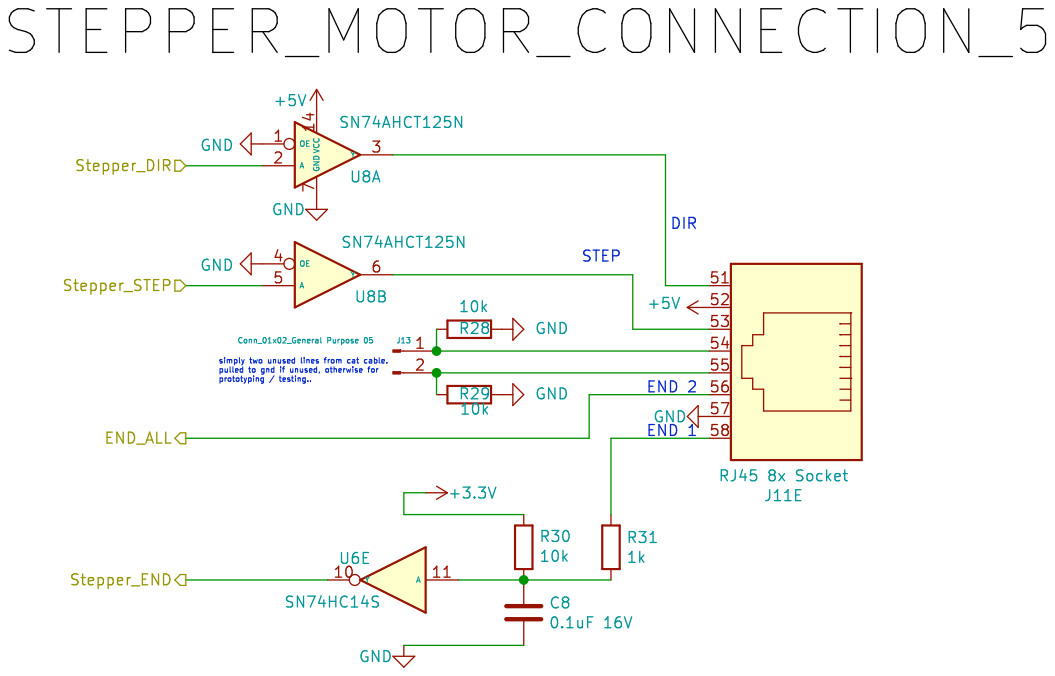
[picture p65: page 6]

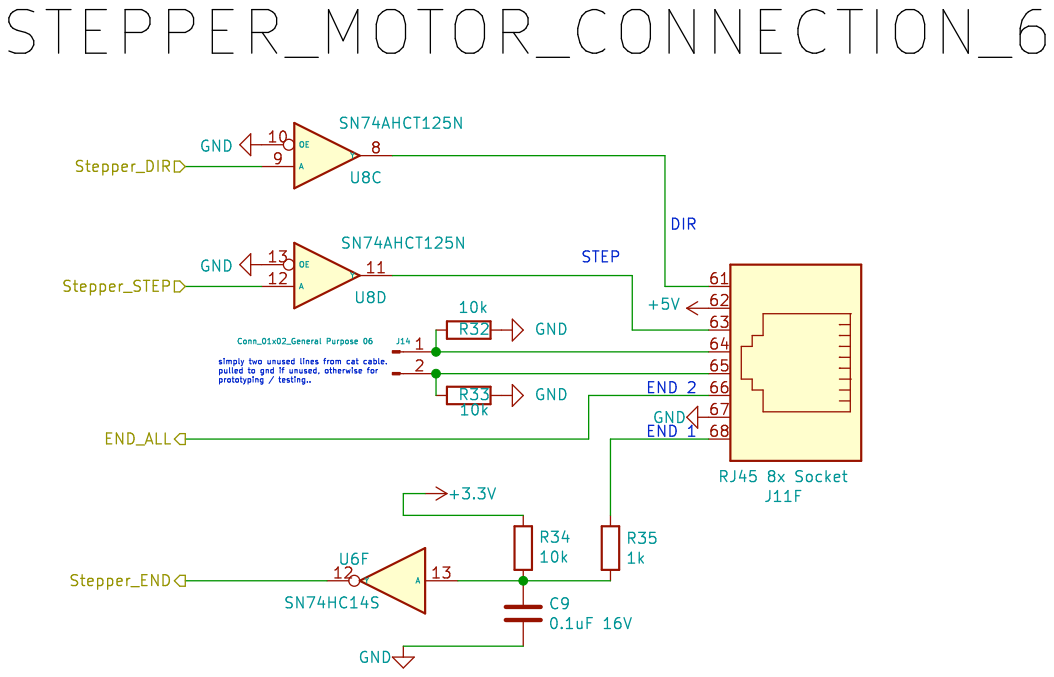
[picture p66: page 7]

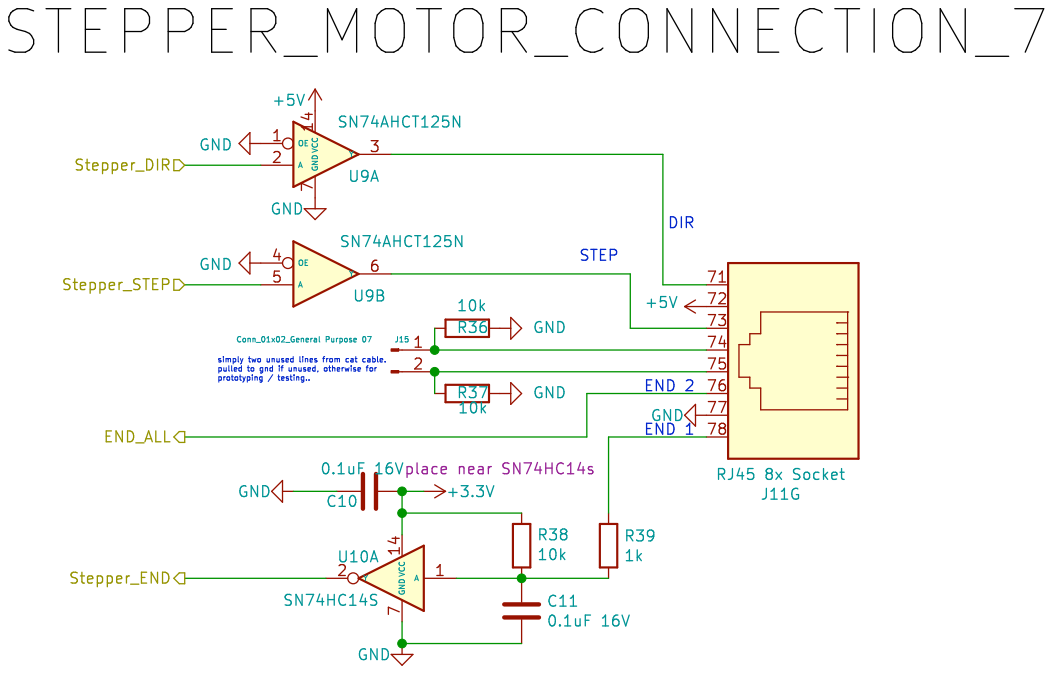
[picture p67: page 8]

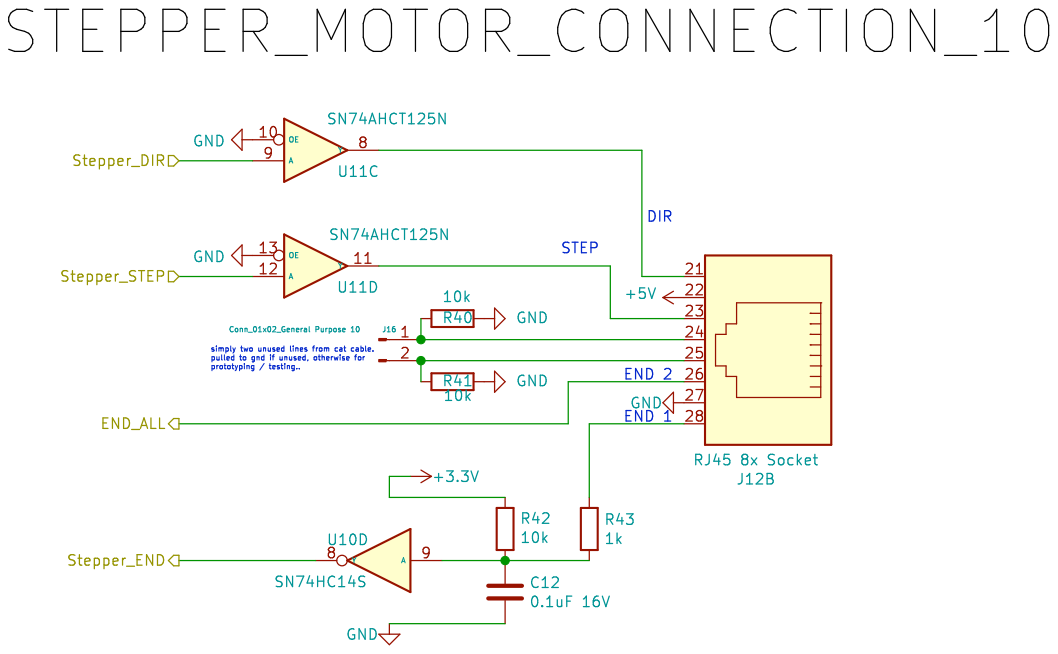
[picture p68: page 9]

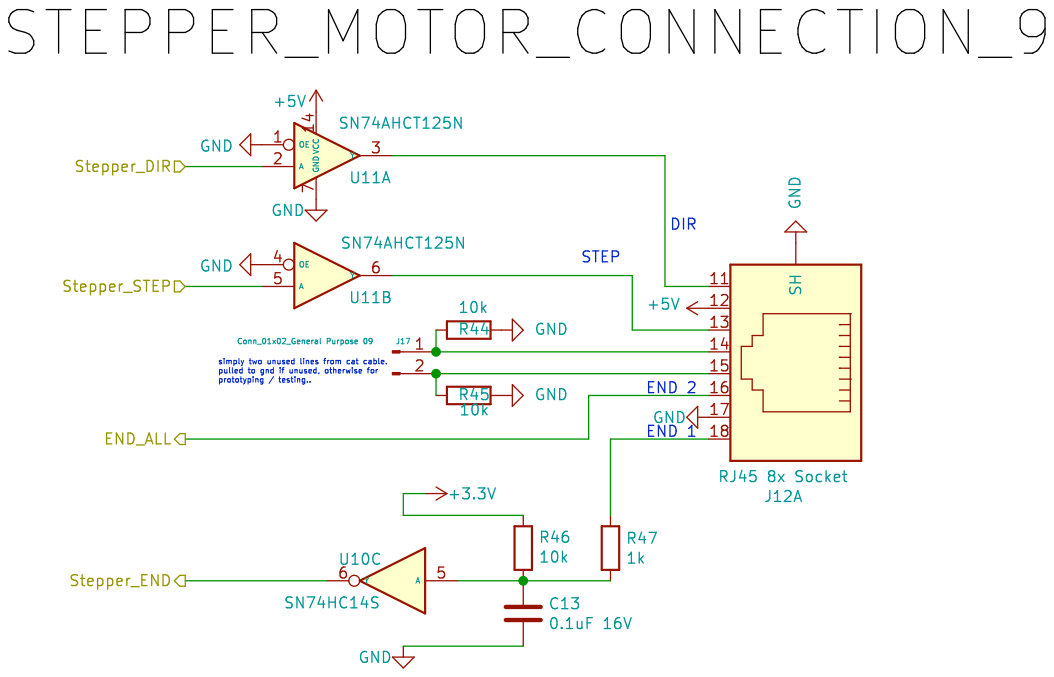
[picture p69: page 10]

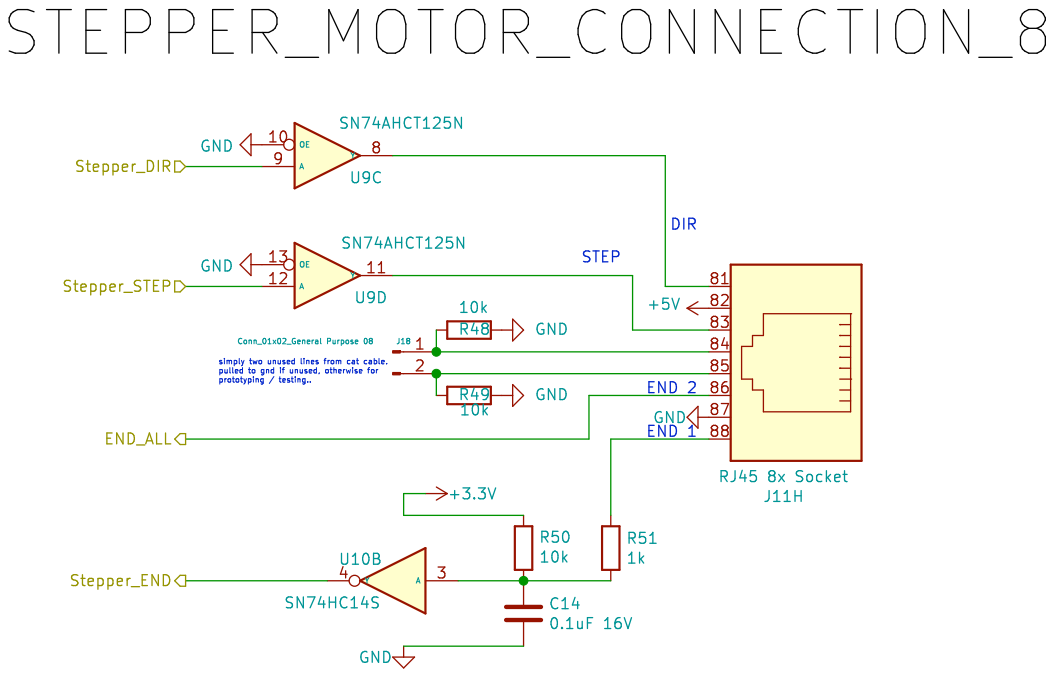
[picture p70: page 11]

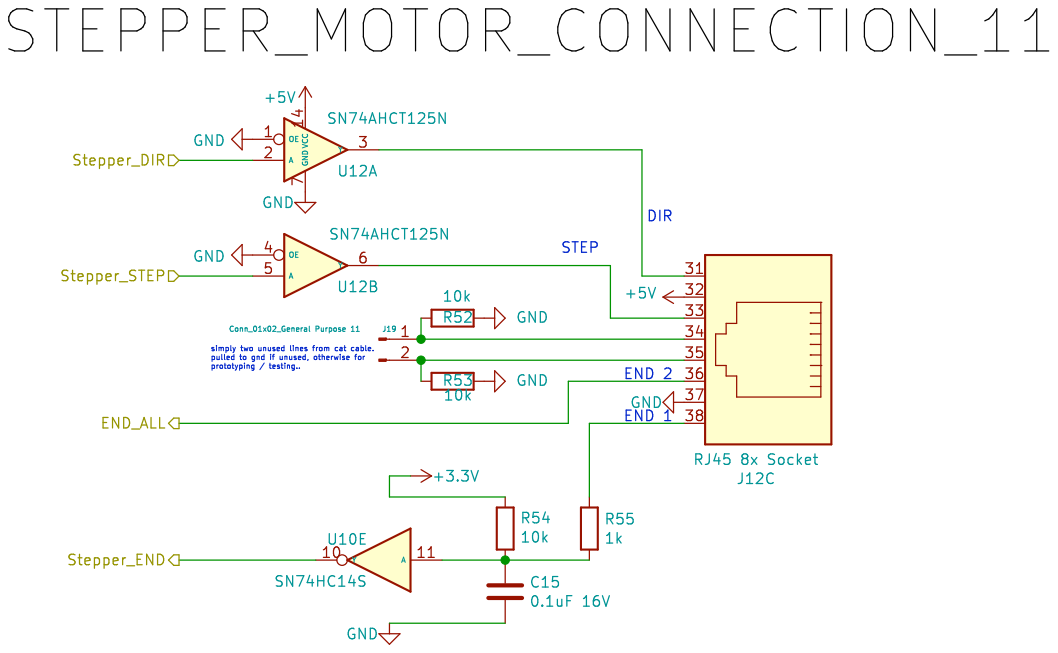
[picture p71: page 12]

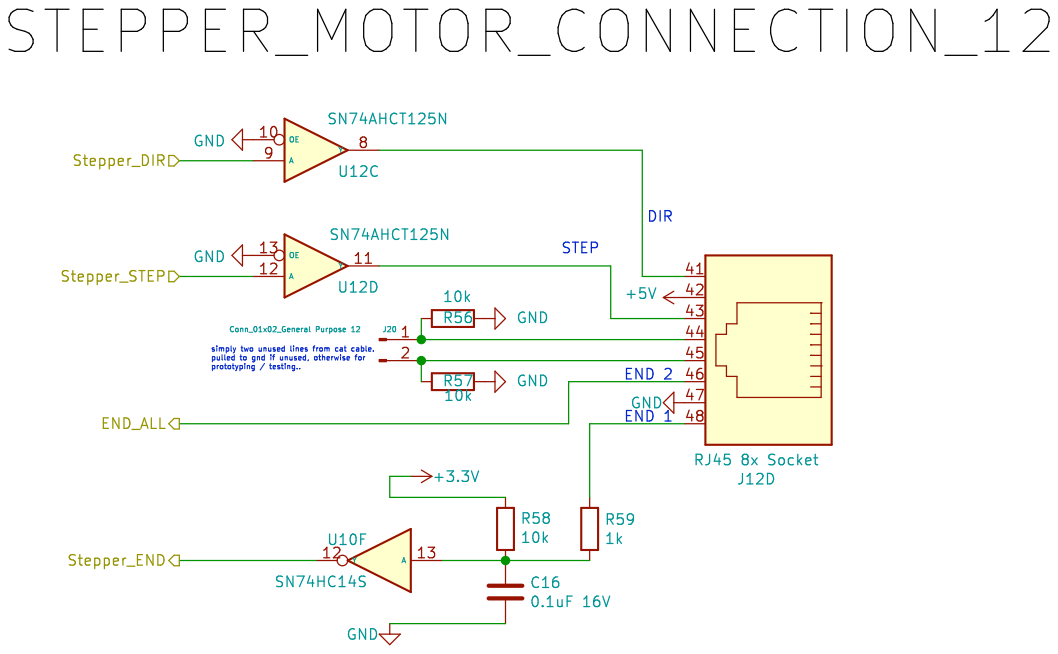
[picture p72: page 13]

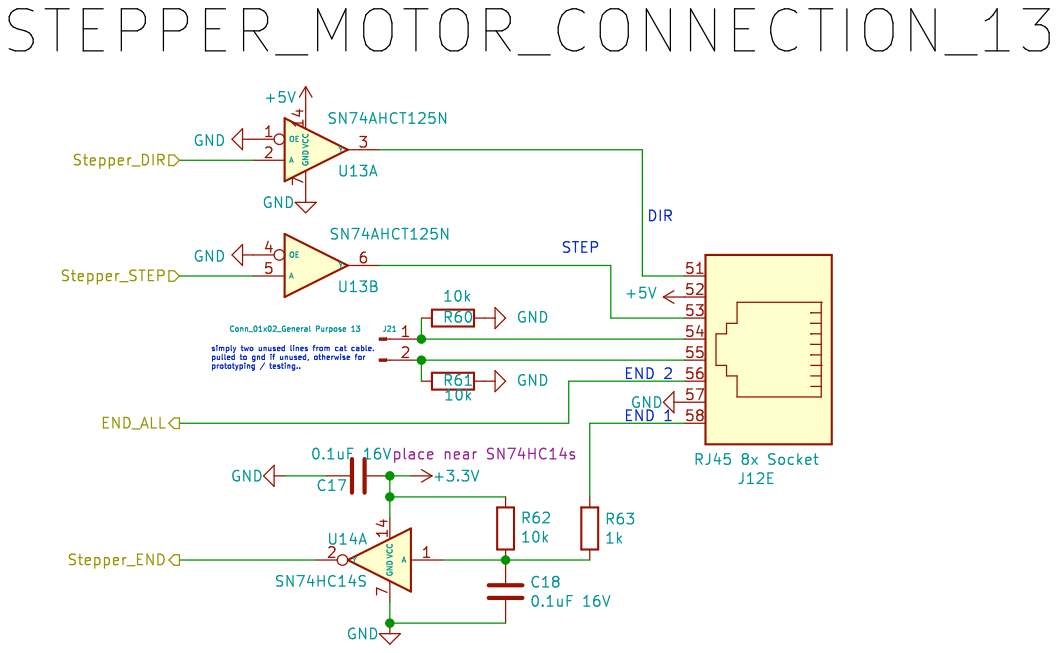
[picture p73: page 14]

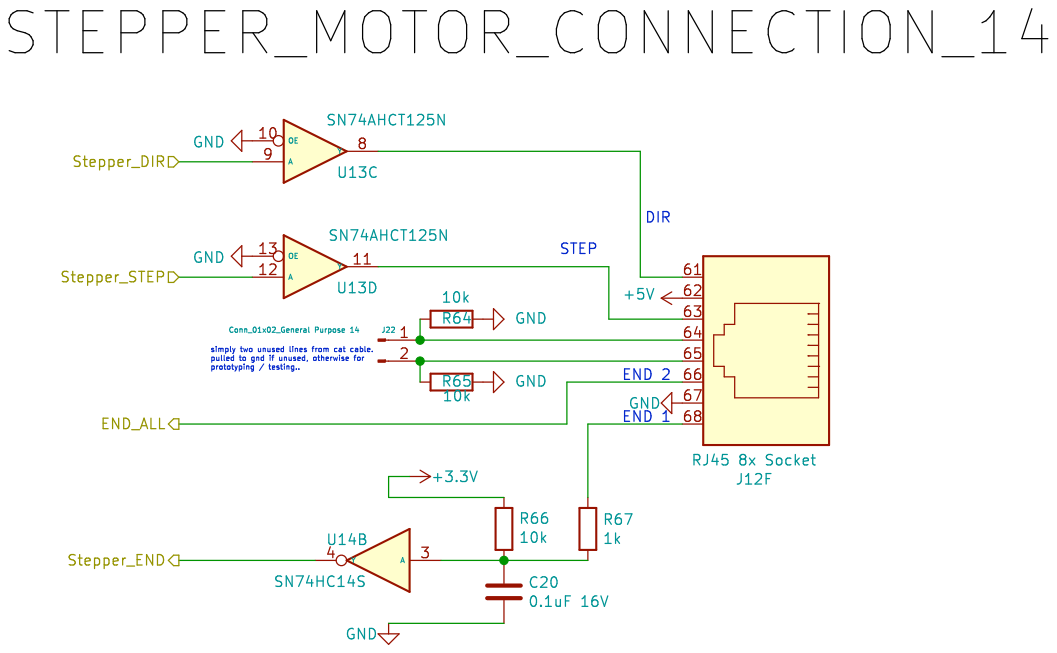
[picture p74: page 15]
