clockdiv/MechanicalTheatre/(list of files, drawings)

Other design files:
HARDWARE/PCB/MechanicalTheatre/MechanicalTheatre.dsn
