clockdiv/MechanicalTheatre/HARDWARE/PCB/MechanicalTheatre/MechanicalTheatre.kicad_pcb

## KiCad design HARDWARE/PCB/MechanicalTheatre/MechanicalTheatre.kicad_pcb (2021-08-30)

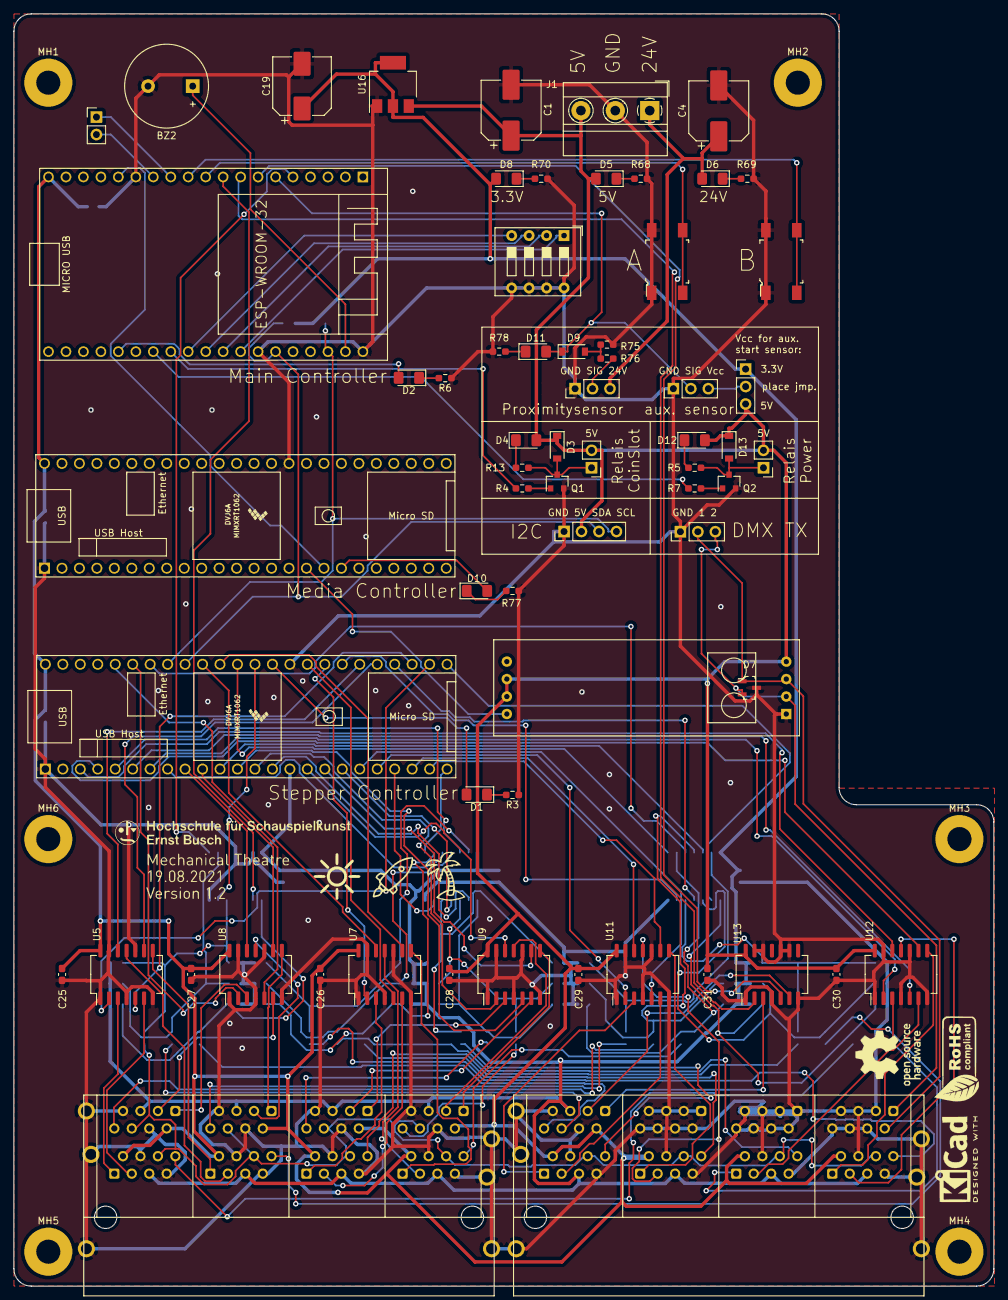
[picture p75: board MechanicalTheatre.kicad_pcb from above]

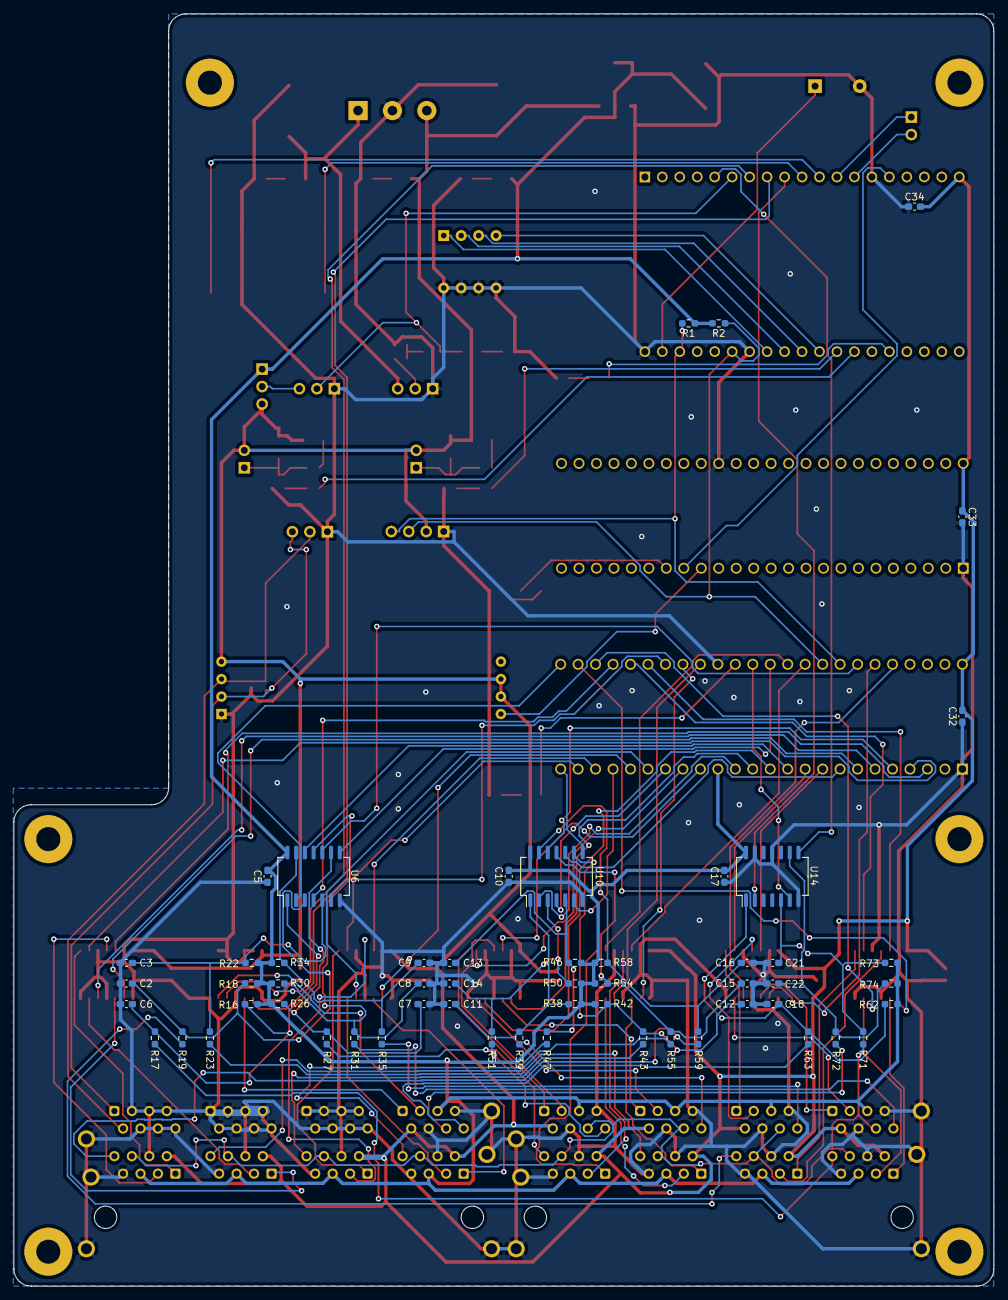
[picture p76: board MechanicalTheatre.kicad_pcb from below]

Board: 2 copper layers, 142.5 x 185.0 mm, 128 parts (56 on the bottom side), 138 nets.

Parts:
A1: MAX485-Shield
BZ2: Buzzer; Buzzer_12x9.5RM6.5
C1, C4: 220uF, 35V; CP_Elec_8x10.5
C2, C3, C5, C6, C7, C8, C9, C10, C11, C12, C13, C14, C15, C16, C17, C18, C21, C22, C25, C26, C27, C28, C29, C30, C31, C32, C33, C34: 0.1uF 16V; C_0603_1608Metric_Pad1.08x0.95mm_HandSolder
C19: 100uF, 25V; CP_Elec_8x10
D1, D2, D4, D5, D6, D8, D10, D11, D12: LED; LED_1206_3216Metric_Pad1.42x1.75mm_HandSolder
D3, D9, D13: 1N4148; D_SOD-123
D7: SM712_TCT; SOT-23-3
G1: LOGO; Silkscreen
J1: Power In 5V/24V; TerminalBlock_MetzConnect_Type011_RT05503HBWC_1x03_P5.00mm_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
J2: Conn_01x02_Male_Telefon?; PinHeader_1x02_P2.54mm_Vertical
J3: Conn_E-Magnet; PinHeader_1x02_P2.54mm_Vertical
J4: Conn_PowerRelais; PinHeader_1x02_P2.54mm_Vertical
J5: Conn_01x03_Male_DMX_TX; PinHeader_1x03_P2.54mm_Vertical
J6: Conn_01x03_ExternalSensor; PinHeader_1x03_P2.54mm_Vertical
J8: Conn_01x04_I2C_Display_20x4; PinHeader_1x04_P2.54mm_Vertical
J9: Conn_01x03_ProximitySensor; PinHeader_1x03_P2.54mm_Vertical
J11, J12: RJ45 8x Socket; RJ45_Conrad_8x
JP1: Jumper_3_Open; PinHeader_1x03_P2.54mm_Vertical
MH1, MH2, MH3, MH4, MH5, MH6: MountingHole_3.5mm_Pad
Q1, Q2: BC848; SOT-23
R1, R2, R75: 4.7k; R_0603_1608Metric_Pad0.98x0.95mm_HandSolder
R3, R5, R6, R13, R70, R77, R78: 100; R_0603_1608Metric_Pad0.98x0.95mm_HandSolder
R4, R7, R17, R19, R23, R27, R31, R35, R39, R43, R47, R51, R55, R59, R63, R71, R72: 1k; R_0603_1608Metric_Pad0.98x0.95mm_HandSolder
R16, R18, R22, R26, R30, R34, R38, R42, R46, R50, R54, R58, R62, R73, R74, R76: 10k; R_0603_1608Metric_Pad0.98x0.95mm_HandSolder
R68: 150; R_0603_1608Metric_Pad0.98x0.95mm_HandSolder
R69: 1.2k; R_0603_1608Metric_Pad0.98x0.95mm_HandSolder
S1: Start Show; Switch_Tactile_SMD_6x6mm
S2: Stop Show; Switch_Tactile_SMD_6x6mm
SW1: SW_DIP_x04; SW_DIP_SPSTx04_Slide_9.78x12.34mm_W7.62mm_P2.54mm
U1, U15: Teensy4.1_OuterPins; Teensy41_OuterPinsOnly
U2: ESP32-DEVKITC-32D; MODULE_ESP32-DEVKITC-32D
U5, U7, U8, U9, U11, U12, U13: SN74AHCT125N; SO-14_5.3x10.2mm_P1.27mm
U6, U10, U14: SN74HC14S; SO-14_5.3x10.2mm_P1.27mm
U16: LM1117-3.3; SOT-223-3_TabPin2

Connections:
+3V3: C5.2, C10.2, C17.2, C19.1, D8.2, J11.15, J11.25, J11.35, J11.45, J11.55, J11.65, J11.75, J11.85, J12.15, J12.25, J12.35, J12.45, J12.55, JP1.1, R1.1, R2.2, R16.2, R18.2, R22.2, R26.2, R30.2, R34.2, R38.2, R42.2, R46.2, R50.2, R54.2, R58.2, R62.2, R73.2, R74.2, U1.15, U6.14, U10.14, U14.14, U16.2
+5V: A1.1, A1.6, A1.7, C1.1, C25.2, C26.2, C27.2, C28.2, C29.2, C30.2, C31.2, C32.2, C33.1, C34.2, D3.1, D4.2, D5.2, D12.2, D13.1, J1.3, J3.2, J4.2, J8.2, J11.12, J11.22, J11.32, J11.42, J11.52, J11.62, J11.72, J11.82, J12.12, J12.22, J12.32, J12.42, J12.52, JP1.3, U1.48, U2.19, U5.14, U7.14, U8.14, U9.14, U11.14, U12.14, U13.14, U15.48, U16.3
+24V: C4.1, D6.2, J1.1, J9.3
/DMX_TX: A1.5, U15.16
/GENERAL_END_SWITCH_TEENSY: J11.16, J11.26, J11.36, J11.46, J11.56, J11.66, J11.76, J11.86, J12.16, J12.26, J12.36, J12.46, R71.2
/I2C_SCL: J8.4, R1.2, U1.41, U2.22
/I2C_SDA: J8.3, R2.1, U1.40, U2.25
/PROX_SENSOR: D9.1, D11.2, J6.2, U2.6
/RELAIS_24V+5V: R7.2, U2.32
/RELAIS_E-MAGNET: R4.2, U2.31
/START_STOP_TRIGGER: U2.15, U15.17
/STEPPER_1_DIR: U1.26, U5.2
/STEPPER_1_END: U1.25, U6.2
/STEPPER_1_STEP: U1.27, U5.5
/STEPPER_2_DIR: U1.29, U5.9
/STEPPER_2_END: U1.28, U6.4
/STEPPER_2_STEP: U1.30, U5.12
/STEPPER_3_DIR: U1.32, U7.2
/STEPPER_3_END: U1.31, U6.6
/STEPPER_3_STEP: U1.33, U7.5
/STEPPER_4_DIR: U1.38, U7.9
/STEPPER_4_END: U1.37, U6.8
/STEPPER_4_STEP: U1.39, U7.12
/STEPPER_5_DIR: U1.43, U8.2
/STEPPER_5_END: U1.42, U6.10
/STEPPER_5_STEP: U1.44, U8.5
/STEPPER_6_DIR: U1.10, U8.9
/STEPPER_6_END: U1.11, U6.12
/STEPPER_6_STEP: U1.9, U8.12
/STEPPER_7_DIR: U1.13, U9.2
/STEPPER_7_END: U1.14, U10.2
/STEPPER_7_STEP: U1.12, U9.5
/STEPPER_8_DIR: U1.17, U9.9
/STEPPER_8_END: U1.18, U10.4
/STEPPER_8_STEP: U1.16, U9.12
/STEPPER_9_DIR: U1.20, U11.2
/STEPPER_9_END: U1.21, U10.6
/STEPPER_9_STEP: U1.19, U11.5
/STEPPER_10_DIR: U1.23, U11.9
/STEPPER_10_END: U1.24, U10.8
/STEPPER_10_STEP: U1.22, U11.12
/STEPPER_11_DIR: U1.7, U12.2
/STEPPER_11_END: U1.8, U10.10
/STEPPER_11_STEP: U1.6, U12.5
/STEPPER_12_DIR: U1.4, U12.9
/STEPPER_12_END: U1.5, U10.12
/STEPPER_12_STEP: U1.3, U12.12
/STEPPER_13_DIR: U2.8, U13.2
/STEPPER_13_END: U2.9, U14.2
/STEPPER_13_STEP: U2.7, U13.5
/Stepper Connection 13/END_ALL: J12.56, R72.2
/TEENSY_GENERAL_ENDSWITCH_DEBOUNCED: U1.36, U14.6
GND: A1.4, BZ2.2, C1.2, C2.2, C3.2, C4.2, C5.1, C6.2, C7.2, C8.2, C9.2, C10.1, C11.2, C12.2, C13.2, C14.2, C15.2, C16.2, C17.1, C18.2, C19.2, C21.2, C22.2, C25.1, C26.1, C27.1, C28.1, C29.1, C30.1, C31.1, C32.1, C33.2, C34.1, D7.3, J1.2, J5.1, J6.1, J8.1, J9.1, J11.14, J11.17, J11.24, J11.27, J11.34, J11.37, J11.44, J11.47, J11.54, J11.57, J11.64, J11.67, J11.74, J11.77, J11.84, J11.87, J11.SH, J12.14, J12.17, J12.24, J12.27, J12.34, J12.37, J12.44, J12.47, J12.54, J12.57, J12.61, J12.62, J12.63, J12.64, J12.65, J12.66, J12.67, J12.68, J12.71, J12.72, J12.73, J12.74, J12.75, J12.76, J12.77, J12.78, J12.83, J12.84, J12.85, J12.86, J12.87, J12.88, J12.SH, Q1.2, Q2.2, R3.1, R6.1, R68.2, R69.1, R70.2, R75.1, R77.1, R78.1, S1.1, S1.2, S2.1, S2.2, SW1.5, SW1.6, SW1.7, SW1.8, U1.1, U1.34, U2.14, U2.20, U2.26, U5.1, U5.4, U5.7, U5.10, U5.13, U6.7, U7.1, U7.4, U7.7, U7.10, U7.13, U8.1, U8.4, U8.7, U8.10, U8.13, U9.1, U9.4, U9.7, U9.10, U9.13, U10.7, U11.1, U11.4, U11.7, U11.10, U11.13, U12.1, U12.4, U12.7, U12.10, U12.13, U13.1, U13.4, U13.7, U13.9, U13.10, U13.12, U13.13, U14.7, U14.11, U14.13, U15.1, U15.34, U16.1
unnamed: A1.2, D7.1, J5.2, J12.82
unnamed: A1.3, D7.2, J5.3, J12.81
unnamed: BZ2.1, U2.21
unnamed: C2.1, R18.1, R19.2, U6.3
unnamed: C3.1, R22.1, R23.2, U6.5
unnamed: C6.1, R16.1, R17.2, U6.1
unnamed: C7.1, R26.1, R27.2, U6.9
unnamed: C8.1, R30.1, R31.2, U6.11
unnamed: C9.1, R34.1, R35.2, U6.13
unnamed: C11.1, R38.1, R39.2, U10.1
unnamed: C12.1, R42.1, R43.2, U10.9
unnamed: C13.1, R46.1, R47.2, U10.5
unnamed: C14.1, R50.1, R51.2, U10.3
unnamed: C15.1, R54.1, R55.2, U10.11
unnamed: C16.1, R58.1, R59.2, U10.13
unnamed: C18.1, R62.1, R63.2, U14.1
unnamed: C21.1, R71.1, R73.1, U14.5
unnamed: C22.1, R72.1, R74.1, U14.9
unnamed: D1.1, R3.2
unnamed: D1.2, U1.35
unnamed: D2.1, R6.2
unnamed: D2.2, U2.34
unnamed: D3.2, J3.1, Q1.3, R13.1
unnamed: D4.1, R13.2
unnamed: D5.1, R68.1
unnamed: D6.1, R69.2
unnamed: D8.1, R70.1
unnamed: D9.2, R75.2, R76.1
unnamed: D10.1, R77.2
unnamed: D10.2, U15.18
unnamed: D11.1, R78.2
unnamed: D12.1, R5.2
unnamed: D13.2, J4.1, Q2.3, R5.1
unnamed: J2.1, U2.12
unnamed: J2.2, U2.13
unnamed: J6.3, JP1.2
unnamed: J9.2, R76.2
unnamed: J11.11, U5.3
unnamed: J11.13, U5.6
unnamed: J11.18, R17.1
unnamed: J11.21, U5.8
unnamed: J11.23, U5.11
unnamed: J11.28, R19.1
unnamed: J11.31, U7.3
unnamed: J11.33, U7.6
unnamed: J11.38, R23.1
unnamed: J11.41, U7.8
unnamed: J11.43, U7.11
unnamed: J11.48, R27.1
unnamed: J11.51, U8.3
unnamed: J11.53, U8.6
unnamed: J11.58, R31.1
unnamed: J11.61, U8.8
unnamed: J11.63, U8.11
unnamed: J11.68, R35.1
unnamed: J11.71, U9.3
unnamed: J11.73, U9.6
unnamed: J11.78, R39.1
unnamed: J11.81, U9.8
unnamed: J11.83, U9.11
unnamed: J11.88, R51.1
unnamed: J12.11, U11.3
unnamed: J12.13, U11.6
unnamed: J12.18, R47.1
unnamed: J12.21, U11.8
unnamed: J12.23, U11.11
unnamed: J12.28, R43.1
unnamed: J12.31, U12.3
unnamed: J12.33, U12.6
unnamed: J12.38, R55.1
unnamed: J12.41, U12.8
unnamed: J12.43, U12.11
unnamed: J12.48, R59.1
unnamed: J12.51, U13.3
unnamed: J12.53, U13.6
unnamed: J12.58, R63.1
unnamed: Q1.1, R4.1
unnamed: Q2.1, R7.1
unnamed: S1.3, S1.4, U2.10
unnamed: S2.3, S2.4, U2.11
unnamed: SW1.1, U2.27
unnamed: SW1.2, U2.28
unnamed: SW1.3, U2.29
unnamed: SW1.4, U2.30
unnamed: U2.5, U14.8
