clockdiv/MechanicalTheatre/HARDWARE/PCB/RJ45-Terminalblock-Adapter/RJ45-Terminalblock-Adapter.kicad_pcb

## KiCad design HARDWARE/PCB/RJ45-Terminalblock-Adapter/RJ45-Terminalblock-Adapter.kicad_pcb (2021-07-06)

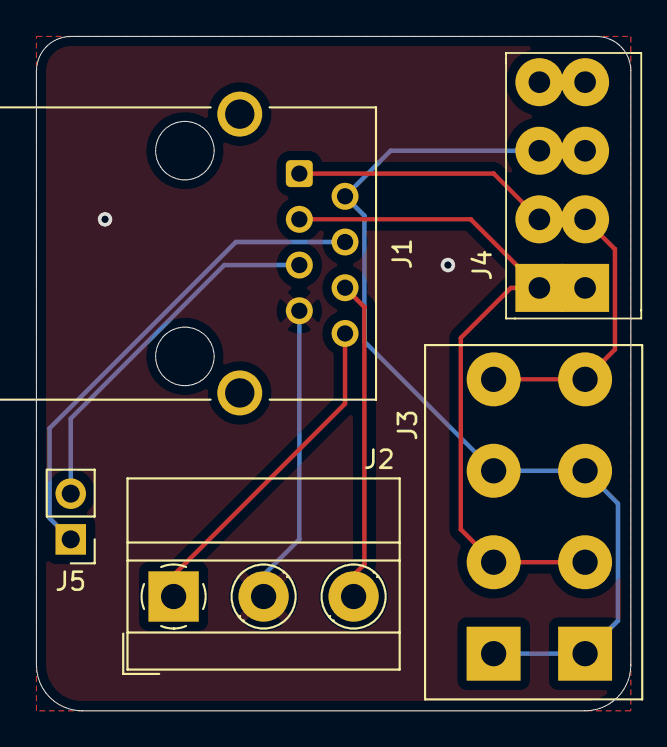
[picture p77: board RJ45-Terminalblock-Adapter.kicad_pcb from above]

Board: 2 copper layers, 33.0 x 37.5 mm, 5 parts (0 on the bottom side), 8 nets.

Parts:
J1: RJ45; RJ45_Conrad_1586526
J2: Screw_Terminal_01x03; TerminalBlock_MetzConnect_Type011_RT05503HBWC_1x03_P5.00mm_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
J3: Conn_01x04 5.08; Terminalblock_1x4_5.08mm
J4: Conn_01x04 3.81; Terminalblock_1x4_3.81mm
J5: Conn_01x02_Male; PinHeader_1x02_P2.54mm_Vertical

Connections:
/5V: J1.2, J3.1, J3.3, J4.3
/DIR: J1.1, J3.4, J4.2
/END_SW_1: J1.8, J2.1
/END_SW_2: J1.6, J2.3
/GND: J1.7, J2.2
/STEP: J1.3, J3.2, J4.1
unnamed: J1.4, J5.1
unnamed: J1.5, J5.2
