clockdiv/MechanicalTheatre/DEV ARDUINO/MediaController v1.2/include/pins.h

#ifndef PINS_H
#define PINS_H

// Use these with the Teensy Audio Shield
#define SDCARD_CS_PIN 10
#define SDCARD_MOSI_PIN 7
#define SDCARD_SCK_PIN 14

// outputs
#define PIN_EXT_LED             26
// inputs
#define PIN_START_STOP_TRIGGER  27


#endif
