clockdiv/MechanicalTheatre/DEV ARDUINO/MainController v1.2/include/Configurations.h

#ifndef CONFIGURATIONS_H
#define CONFIGURATIONS_H
#include <Arduino.h>
#include "Pins.h"

#define TEENSY_I2C_ADDR 0x10
#define DEBOUNCE_TIME   25

// Usage of EEPROM:
// 4 Bytes for uint32_t showCounter ManualStart
// 4 Bytes for uint32_t showCounter CoinslotStart
// 4 Bytes for uint32_t showCounter TelephoneStart
#define EEPROM_SIZE 64


// Signals for the Buzzer:
// 100-199: info messages
// 200-299: error messages
#define BUZZER_TEST         100
#define BUZZER_POWER_ON     101
#define BUZZER_START_SHOW   102
#define BUZZER_STOP_SHOW    103
#define BUZZER_IDLE         104
#define BUZZER_FEIERABEND   105

#endif
