clockdiv/MechanicalTheatre/(commit log)

2021-06-01 driving multiple steppers
    [DumpTimelineToFile.blend, memory_consumption.ods]
2021-06-03 motor direction invert; end-switch
    - directionInvert added to MotorUnit::initDriver method
    - only basic test for the end-switch, no functional implementation yet
    [DumpTimelineToFile.blend]
2021-06-03 Init motors at end switches
    added windows-support for serialport list in blender add-on. todo: switch os automatically
    [DumpTimelineToFile.blend]
2021-06-07 Create ESP32_MainController.ino
    First quick test for the proximity sensor
2021-06-08 Update ESP32_MainController.ino
    state machine, work in progress
2021-06-09 Update ESP32_MainController.ino
    updated pin numbers, minor logic changes
2021-06-13 KiCad schematic
    [MechanicalTheatre.kicad_pcb, MechanicalTheatre.sch]
2021-06-14 update to esp32_maincontroller
2021-06-14 i2c Communication esp32
    Communication between teensy and esp32
2021-06-14 i2c Communication Teensy
    Communication between Teensy and ESP32
2021-06-14 i2c Communication
2021-07-06 main pcb v1.0
    [MechanicalTheatre-B_Cu.gbl, MechanicalTheatre-B_Mask.gbs, MechanicalTheatre-B_Paste.gbp, MechanicalTheatre-B_SilkS.gbo, MechanicalTheatre-Edge_Cuts.gm1, MechanicalTheatre-F_Cu.gtl, MechanicalTheatre-F_Mask.gts, MechanicalTheatre-F_Paste.gtp]
2021-07-09 Migration to VSCode #1
    VSCode Project for StepperController
    [Configurations.h]
2021-07-09 fixes in kicad file, no actual changes
    [MechanicalTheatre.sch, StepperConnection06.sch, StepperConnection07.sch, StepperConnection08.sch, StepperConnection09.sch, StepperConnection10.sch, StepperConnection11.sch, StepperConnection12.sch]
2021-07-12 teensy: different motor configurations
    added support for 2, 4 and 10 motor units
    [Configurations10.h, Configurations2.h, Configurations4.h, DumpTimelineToFile.blend]
2021-07-14 minor changes in motor unit
    [Configurations6.h, DumpTimelineToFile.blend]
2021-07-14 StateMachine for MotorUnits
    - added debounce lib for endswitches
    - statemachine for motorunits
    - refactoring and cleanup
    [Configurations10.h, Configurations2.h, Configurations4.h, Configurations7.h, DumpTimelineToFile.blend]
2021-07-19 VSCode Project for MainController (ESP32)
    Created VSCode Project for MainController
    - MainController and StepperController share most of the code now
    [Configurations.h, Configurations10.h, DumpTimelineToFile.blend]
2021-07-26 all Motors in MainController
    - added all Motors on MainController
    - relais
    - keyframeProcess uses proper filenames
    [Configurations.h, DumpTimelineToFile.blend]
2021-07-27 i2c communication teensy-esp
    - ESP32 and Teensy are communicating witih each other via i2c. works but needs improvement..
    [Configurations.h, Configurations10.h]
2021-07-29 Communication between Microcontrollers
    - improved i2c
    - triggered communication between esp and second teensy
    [Configurations10.h, DumpTimelineToFile.blend]
2021-08-02 LED-Wall Tests
    - Tests with the LED-Wall
2021-08-02 added MediaController
    - MediaController plays Audiofiles and the DMX-Show
    - quadrophonic Audioplayback works
    - basic dmx connection works with teensydmx
2021-08-05 new pcb
    Version 1.1 of pcb
    [MechanicalTheatre-B_Cu.gbl, MechanicalTheatre-B_Mask.gbs, MechanicalTheatre-B_Paste.gbp, MechanicalTheatre-B_SilkS.gbo, MechanicalTheatre-Edge_Cuts.gm1, MechanicalTheatre-F_Cu.gtl, MechanicalTheatre-F_Mask.gts, MechanicalTheatre-F_Paste.gtp]
2021-08-18 WiFi and Telegram Support
    added WiFi and Telegram to MainController (esp32)
2021-08-24 Coinslot sensor added
    - coinslot working, inkl. magnet
    - missing motor-reset-dependencies from last merge added
    [Configurations10.h]
2021-08-30 Fixed Motor Movement
    - minPulseWidth set to 15us instead of 50us
    - processing-app to visualize the deltaPosition
    - stateMachine added to MediaController
    [DumpTimelineToFile.blend]
2021-08-30 PCB v1.2
    [MechanicalTheatre-B_Cu.gbl, MechanicalTheatre-B_Mask.gbs, MechanicalTheatre-B_Paste.gbp, MechanicalTheatre-B_SilkS.gbo, MechanicalTheatre-Edge_Cuts.gm1, MechanicalTheatre-F_Cu.gtl, MechanicalTheatre-F_Mask.gts, MechanicalTheatre-F_Paste.gtp]
2021-08-30 Hardware Test for PCB v1.2
    - MediaController Start_Stop_Trigger needs to be Pin 27, not 25
    [Configurations.h, Configurations10.h, Configurations12.h, Configurations2.h, Configurations4.h, Configurations6.h, Configurations7.h, DumpTimelineToFile.blend]
2021-09-02 updates on MediaController
    [DumpTimelineToFile.blend, configurations.h]
2021-09-02 changed MediaController
    - no Interrupt pin, but normal debounced triggerinput
2021-09-03 updates on all
    - StepperController deletes it's files before new upload
    - i2c Handler debug
    - MediaController turns all LEDs off
    [DumpTimelineToFile.blend]
2021-09-03 StepperController
    - changed stupid timing error
    - changes in configuration12 file
    [Configurations12.h]
2021-09-03 changes in MediaController
    - fixed stupid timing error
    - added feature to keep power supply always on in maincontroller
    [DumpTimelineToFile.blend]
2021-09-03 swaped i2c with pin-requests
    [Configurations12.h]
2021-09-03 Stepper and Media
    [Configurations12.h]
2021-09-04 stepper + mediacontroller
    - using i2c again for communication
    - mediacontroller still crashing
    [Pins.h, i2cHandler.cpp, i2cHandler.h, main.cpp]
2021-09-05 stepper controller i2c test
    [Configurations12.h]
2021-09-05 main controller i2c test function
    [DumpTimelineToFile.blend]
2021-09-06 Bugfixes
    - memory access error fixed
    - StateToString in MotorUnit (not yet in Main)
    [Configurations12.h, DumpTimelineToFile.blend]
2021-09-07 Code refactoring
    - esp32 can send stop signal to teensys
    - stateToString Function in main() on steppercontroller
    [Configurations.h, Configurations10.h, Configurations12.h, Configurations2.h, Configurations4.h, Configurations6.h, Configurations7.h, DumpTimelineToFile.blend]
2021-09-08 added stopsign
    [Configurations.h, DumpTimelineToFile.blend]
2021-09-09 Updates @construction site day 1
    - updated motor-configurations in StepperController
    - temporarly deactivated stop-sign-stepper-motor in MainController
    [Configurations.h, DumpTimelineToFile.blend]
2021-09-10 added Stop-Dependencies for motors
    - Motors watch out for each other, so one connected motor stops when another drives into the endswitch
    - new blender file with movement experiments
    [Configurations.h, DumpTimelineToFile2.blend]
2021-09-10 changes in stepper init positions
    [Configurations.h, DumpTimelineToFile2.blend, DumpTimelineToFile3.blend]
2021-09-12 Media Controller
    - loads dmx data into extmem (psram)
    [configurations.h]
2021-09-13 Media Controller
    - removed some buffer overflows when uploading huge amount of dmx-data
    - added more dmx-channels for background led wall to the blender-file
    [DumpTimelineToFile3.blend]
2021-09-21 added Feierabend-Timer
    - stops after 14 hours
    - number of played shows is stored in eeprom
    [Configurations.h, DumpTimelineToFile3.blend]
2022-07-27 Coinslot Machine added
    [DumpTimelineToFile3.blend, Ingo V2.blend, Ingo V3.blend, Ingo V4.blend, Ingo V5.blend]
